tzarick/Battery-balancer/Software/Logic Flow Diagrams/I2C Coms/I2C Get State (I2C_Coms).pdf

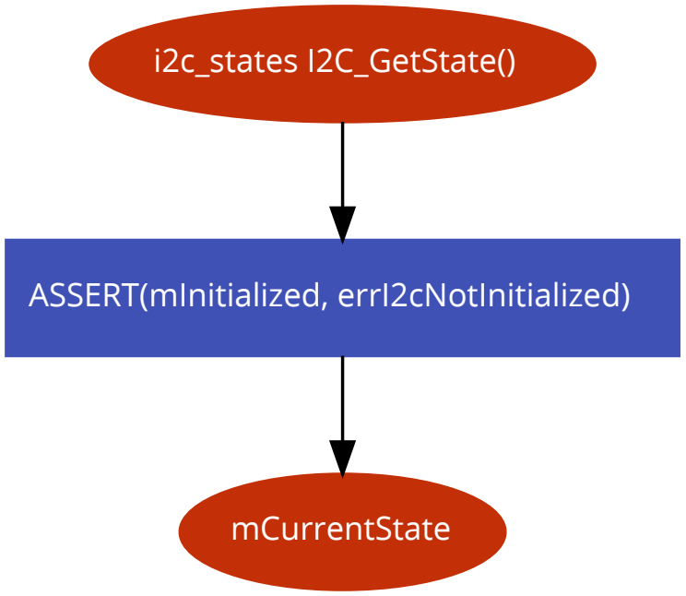
[picture p1: figure]
i2c_states I2C_GetState(); ASSERT(mInitialized, errI2cNotInitialized); mCurrentState
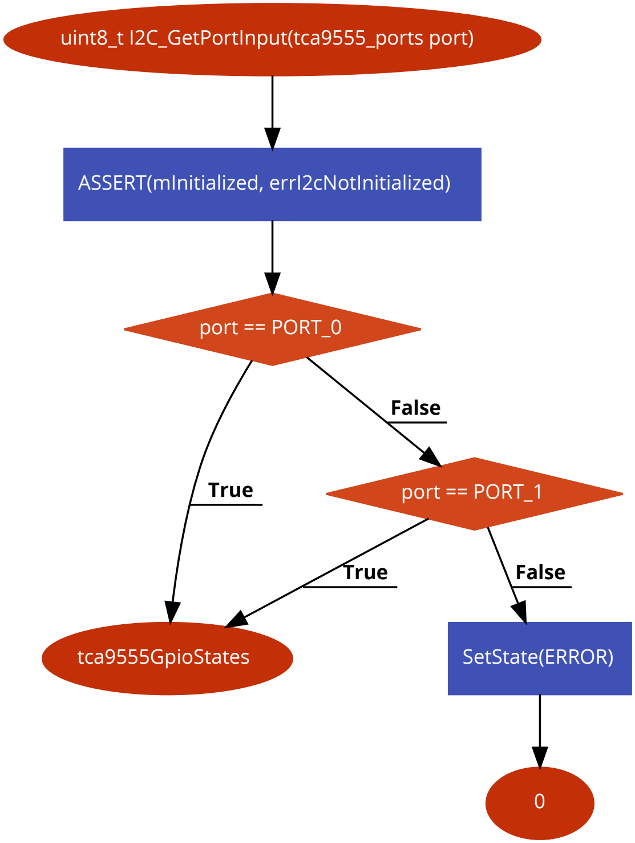
[picture p2: figure]
uint8_t I2C_GetPortInput(tca9555_ports port); ASSERT(mInitialized, errI2cNotInitialized); port == PORT_0; tca9555GpioStates; True; port == PORT_1; False; SetState(ERROR)
