tzarick/Battery-balancer/Software/Logic Flow Diagrams/I2C Coms/I2C Set Port Output  (I2C_Coms).pdf

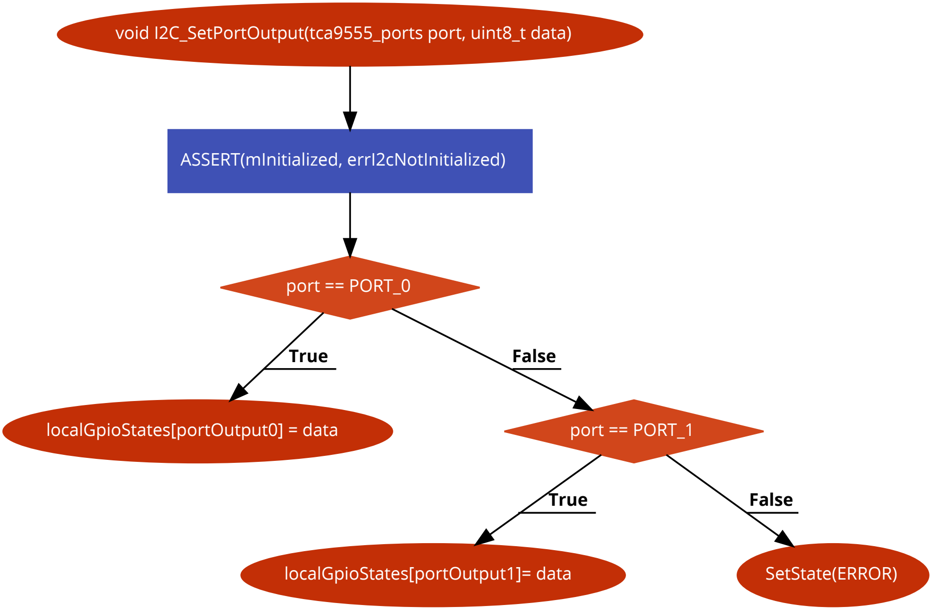
[picture p3: figure]
void I2C_SetPortOutput(tca9555_ports port, uint8_t data); ASSERT(mInitialized, errI2cNotInitialized); port == PORT_0; localGpioStates[portOutput0] = data; True; port == PORT_1; False; localGpioStates[portOutput1]= data; SetState(ERROR)
