tzarick/Battery-balancer/Software/Logic Flow Diagrams/I2C Coms/I2C_ReadRegister (I2C Coms).pdf

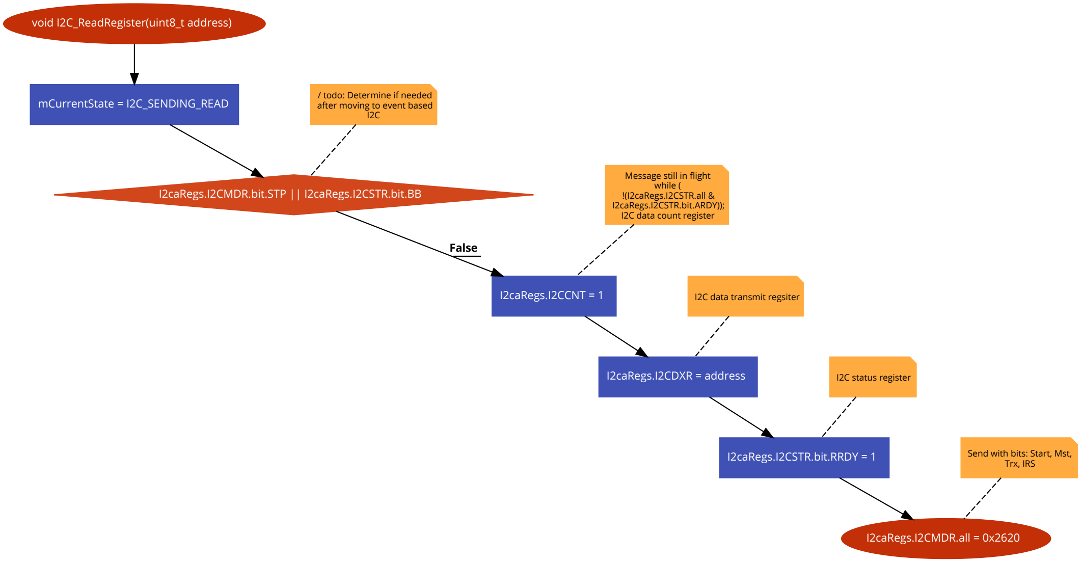
[picture p4: figure]
void I2C_ReadRegister(uint8_t address); mCurrentState = I2C_SENDING_READ; I2caRegs.I2CCNT = 1; False; I2caRegs.I2CDXR = address; I2caRegs.I2CSTR.bit.RRDY = 1; I2caRegs.I2CMDR.all = 0x2620; / todo: Determine if needed after moving to event based I2C; Message still in flight while ( !(I2caRegs.I2CSTR.all & I2caRegs.I2CSTR.bit.ARDY)); I2C data count register; I2C data transmit regsiter; I2C status register; Send with bits: Start, Mst, Trx, IRS

### I2caRegs.I2CMDR.bit.STP || I2caRegs.I2CSTR.bit.BB
