tzarick/Battery-balancer/Hardware/Front panel assembly BOM.xlsx

Qty | Description | Manufacturer | Mfg part | Vendor | Vendor part | Designator | Cost
5 | XH 3pos mating connector | JST | XHP-3 | Newark | 74M5178 |  | 0.043
5 | XH 4pos mating connector | JST | XHP-4 | Newark | 74M5179 |  | 0.059
2 | XH 2pos mating connector | JST | XHP-2 | Newark | 72M6922 |  | 0.039
1 | Micro-Clasp 10pos mating connector | Molex | 51353-1000 | Newark | 58J9303 |  | 0.5
10 | Micro-Clasp terminals | Molex | 56134-9100 | Newark | 59J0986 |  | 0.055
39 | XH terminals | JST | BXH-001T-P0.6 | Newark | 73M9274 |  | 0.069
1 | Green panel-mount pushbutton ind | CW Industries | GPB527C2L02BG1 |  |  |  | 4.34 | ?
1 | Red panel-mount pushbutton ind | CW Industries | GPB527C2L02BR1 |  |  |  | 3.53 | ?
2 | Toggle switches | NKK | M2011SS1W01/UC | Digi-Key | 360-3289-ND |  | 3.31
2 | Panel-mount green/yellow LED | Bivar | PM53-YGW12.0 | Newark | 73R3937 |  | 0.697
1 | LCD with serial backpack | SparkFun | na | SparkFun | LCD-09351 |  | 36.95 | buy it
2 | Panel-mount square momentary pushbutton | E-Switch | PS1057ABLK | Digi-Key | EG2041-ND |  | 1.35
1 | Emergency stop button | Automation Direct | GCX3131 |  |  |  | 9.25
1 | Audible alarm |  | DNP |  |  |  |  | dnp
1 | Front panel PCB - mount |  | PRINT |  |  |  |  | print
4 | M4 threaded insert |  | STOCK
4 | M4 screw |  | STOCK
 | LCD mounting hardware
1 | Front panel (plate with cutouts) |  | MFG HERE
1 | Magic CAN Node v2.3 |  | STOCK
1 | Smaller red panel-mount pushbutton ind | E-Switch | LP1OA1AR | Digi-Key | EG4643-ND |  | 2.95
 |  |  |  |  |  |  | 72.063
