tzarick/Battery-balancer/Hardware/RelayBoard/BoM.xlsx

Sensor Breakout Board V1.0
Qty | Description | Category | Manufacturer | Mfg part | Vendor | Vendor part | Unit cost | Designator
3 | TEXAS INSTRUMENTS DRV8860PW MOTOR DRIVER, STEPPER, 560MA, TSSOP-16 | Driver IC | TI | DRV8860PW | Newark | 11X3139 | $1.96 | U1-U3
24 | Miniature pc mount power relay. 12 Vdc, 400 Ohm coil. SPDT 12A contacts. | Relay | HASCO | KLT1C12DC12 | All Electronics | RLY-717 | $0.75 | K1-K24
24 | Wirewound Resistors THS50 R68 0.68 5% Ohms 50 W | Power Resistor | TE | THS50R68J | Mouser | 279-THS50R68J | $3.01 | R9-R16, R29-R36, R47-R54
1 | LED, Green, 1.25mm x 1.4mm, 570 nm, 2.1 V, 20 mA, 10 mcd | LED | Multicomp | MCL-S270GC | Newark | 14N9356 | $0.13 | LED26
25 | LED, Yellow, 1.25mm x 1.4mm, 590 nm, 2.1 V, 20 mA, 10 mcd | LED | Multicomp | MCL-S270YC | Newark | 14N9359 | $0.09 | LED1-LED25
26 | Surface Mount Chip Resistor, Thick Film, RC Series, 1 kohm, 100 mW, ± 5%, 50 V, 0603 [1608 Metric] (http://www.newark.com/yageo/rc0603jr-131kl/res-thick-film-1k-5-0-1w-0603/dp/68R0220) | Common passives | YAGEO (http://www.newark.com/yageo) | RC0603JR-131KL | Newark | 68R0220 | $0.002 | R1-R8, R19-R26, R37-R44, R55, R56
3 | Surface Mount Chip Resistor, Thick Film, AEC-Q200 CRCW Series, 10 kohm, 100 mW, ± 5%, 75 V (http://www.newark.com/vishay-dale/crcw060310k0jnea/res-thick-film-10k-5-0-1w-0603/dp/52K8066) | Common passives | VISHAY (http://www.newark.com/vishay) | CRCW060310K0JNEA | Newark | 52K8066 | $0.03 | R18, R28, R46
3 | Surface Mount Chip Resistor, Thick Film, AEC-Q200 CRCW Series, 14 kohm, 100 mW, ± 1%, 75 V | Common passives | VISHAY (http://www.newark.com/vishay) | CRCW060314K0FKEA | Newark | 52K8133 | $0.004 | R17, R27, R45
3 | SMD Multilayer Ceramic Capacitor, C Series, 0.1 µF, ± 5%, X7R, 25 V, 0603 [1608 Metric] | Common passives | KEMET | C0603C104J3RACTU | Newark | 01J3308 | $0.04 | C2, C5, C8
3 | SMD Multilayer Ceramic Capacitor, 10 µF, ± 10%, X5R, 6.3 V, 0805 [2012 Metric] | Common passives | AVX | 08056D106KAT2A | Newark | 84K8398 | $0.02 | C1, C4, C7
1 | Board-To-Board Connector, MTA-100 Series, Through Hole, Header, 10, 2.54 mm, Tin Plated Contacts | Connectors | TE CONNECTIVITY / AMP (http://www.newark.com/te-connectivity-amp) | 4-644456-0 | Newark | 15M6349 | $0.63 | JP1-JP5
1 | Wire-To-Board Connector, Micro-Fit 3.0 43045 Series, Through Hole, Header, 12, 3 mm | Connectors | MOLEX (http://www.newark.com/molex) | 43045-1200 | Newark | 56H9564 | $2.80 | X3
 | Subtotal |  |  |  |  |  | $102.37
