tzarick/Battery-balancer/CAD/Balancer/Balancer enclosure.SLDASM

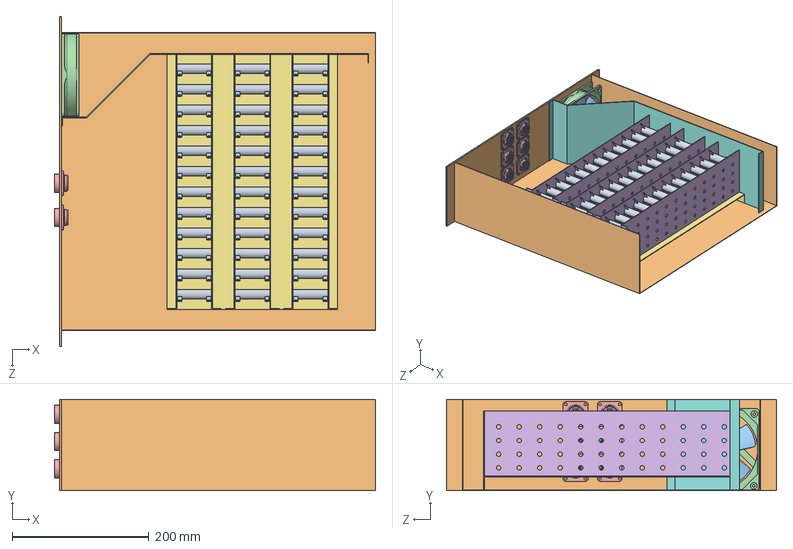
[picture p7: CAD file, 2016-03-14]
CAD/Balancer/Balancer enclosure.SLDASM
469.7 x 133.4 x 482.6 mm
Ohmite L25J1R0E x 144
Vero 503-232949F 3U enclosure
Fan
Fan Housing
205840-3 CPC Series 2 28pos x 6
Resistor side wall x 6
Resistor array bottom wall^Balancer enclosure
Intake manifold wall^Balancer enclosure
