tzarick/Battery-balancer/CAD/Front panel/Front panel printed.SLDASM

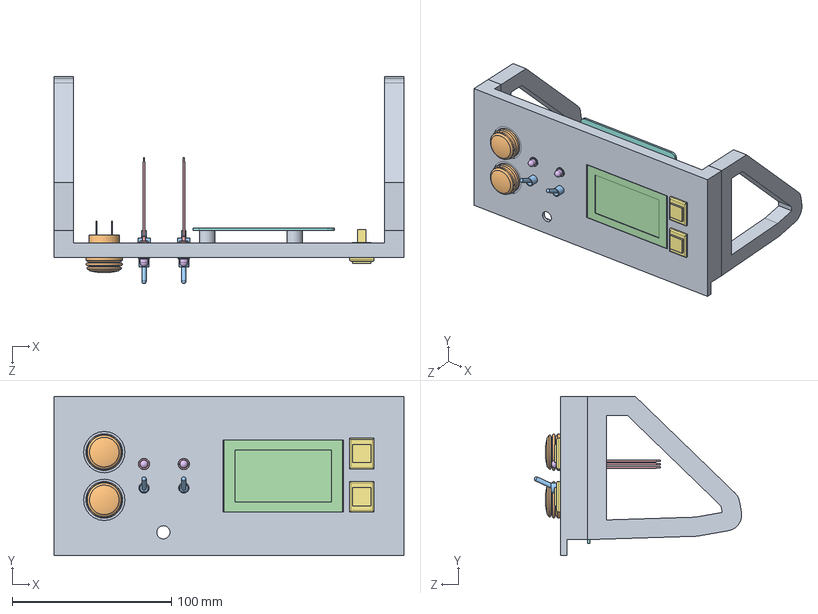
[picture p9: CAD file, 2016-03-14]
CAD/Front panel/Front panel printed.SLDASM
220.0 x 100.0 x 130.4 mm
Front panel print
GPB527C2L02BG1 pushbutton switch x 2
M2011SS1W01 toggle switch x 2
LCD
PM5-3_A1 x 2
LED_5mm x 2
TP11J81ZQE22 pushbutton x 2
Front panel PCB
Foot thing x 2
