tzarick/Battery-balancer/CAD/Front panel/Front panel subcomponents/Front panel PCB.SLDASM

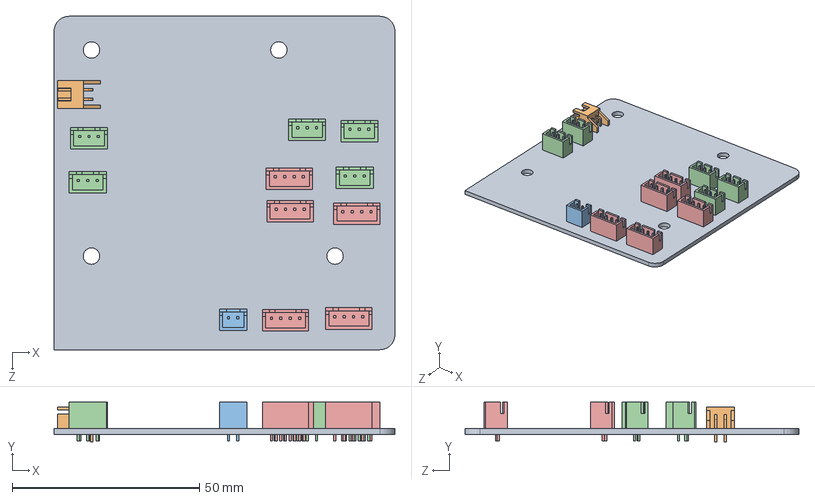
[picture p10: CAD file, 2016-03-14]
CAD/Front panel/Front panel subcomponents/Front panel PCB.SLDASM
91.0 x 10.7 x 89.0 mm
Front panel PCB
B2B-XH-A 2pos RA
B2B-XH-A 2pos vert
B3B-XH-A 3pos vert x 5
B4B-XH-A 4pos vert x 5
