tzarick/Battery-balancer/CAD/Front panel/Front panel subcomponents/Front panel.SLDPRT

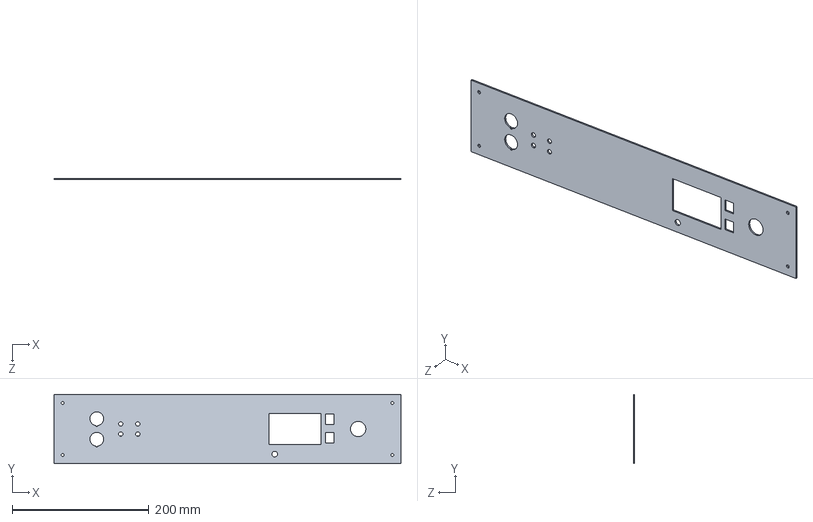
[picture p14: CAD file, 2016-03-14]
CAD/Front panel/Front panel subcomponents/Front panel.SLDPRT
508.0 x 101.6 x 2.10 mm
