tzarick/Battery-balancer/CAD/Front panel/Printing subcomponents/Foot thing.SLDPRT

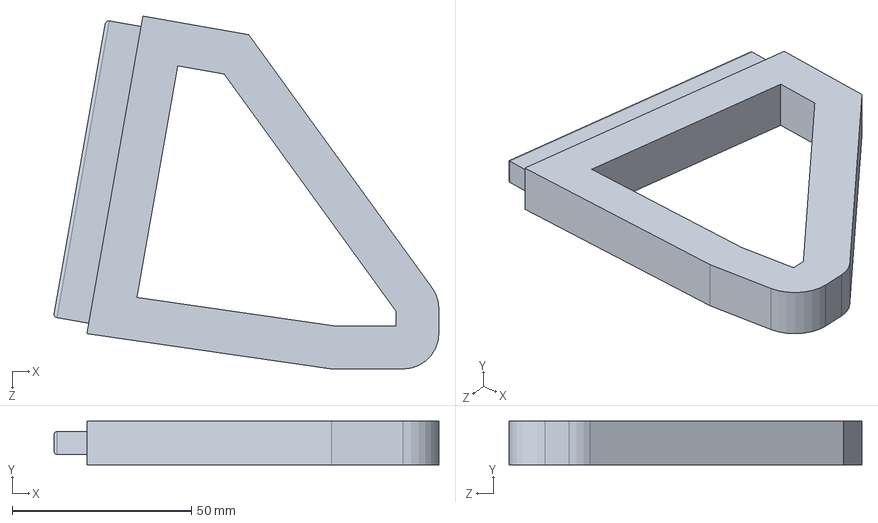
[picture p15: CAD file, 2016-03-14]
CAD/Front panel/Printing subcomponents/Foot thing.SLDPRT
107.4 x 12.2 x 98.5 mm
