tzarick/Battery-balancer/CAD/Balancer/Electrical components/Vero 503-232949F 3U enclosure.SLDPRT

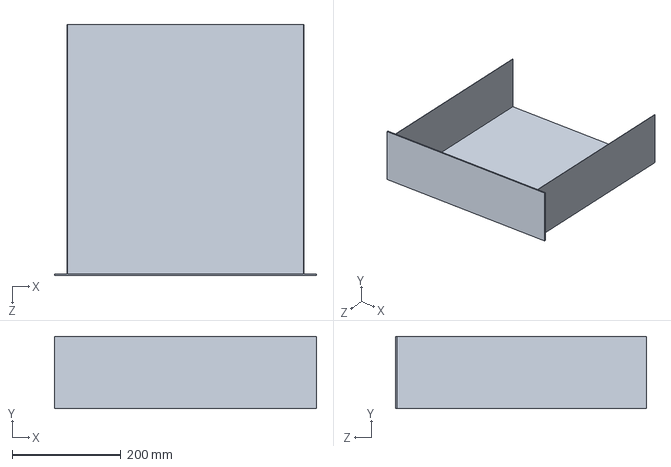
[picture p21: CAD file, 2016-03-14]
CAD/Balancer/Electrical components/Vero 503-232949F 3U enclosure.SLDPRT
482.6 x 133.4 x 462.0 mm
