tzarick/Battery-balancer/CAD/Front panel/Front panel subcomponents/Front panel print.SLDPRT

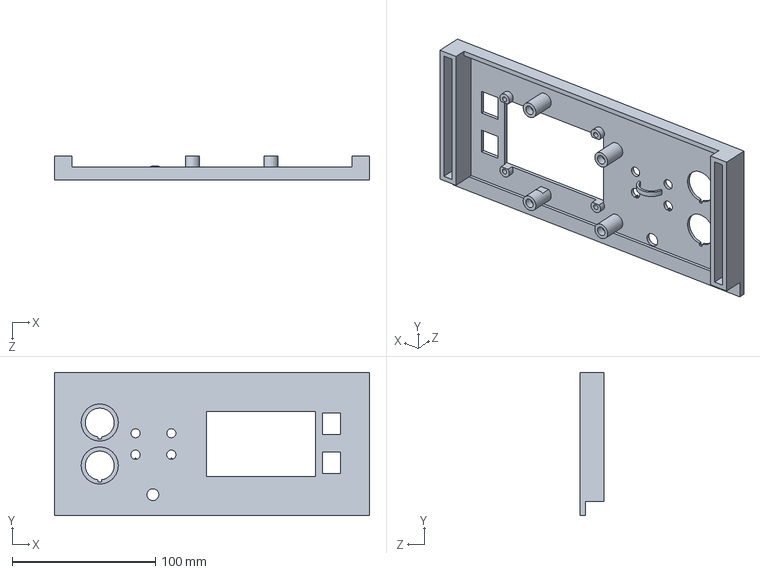
[picture p22: CAD file, 2016-03-14]
CAD/Front panel/Front panel subcomponents/Front panel print.SLDPRT
220.0 x 100.0 x 17.1 mm
