tzarick/Battery-balancer/CAD/Front panel/Front panel subcomponents/LCD.SLDPRT

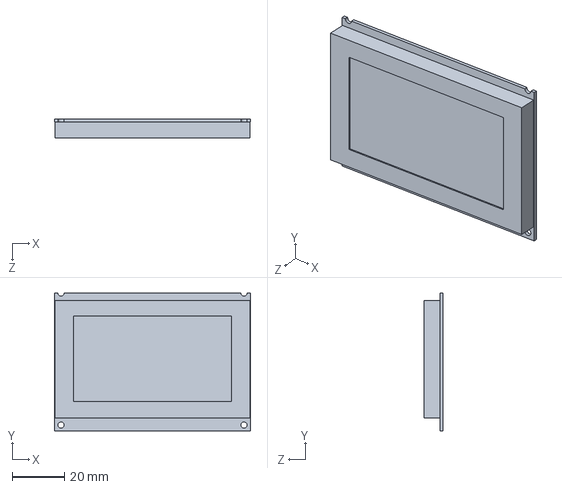
[picture p23: CAD file, 2016-03-14]
CAD/Front panel/Front panel subcomponents/LCD.SLDPRT
75.0 x 52.8 x 7.10 mm
