tzarick/Battery-balancer/CAD/Front panel/Front panel subcomponents/M2011SS1W01 toggle switch.SLDPRT

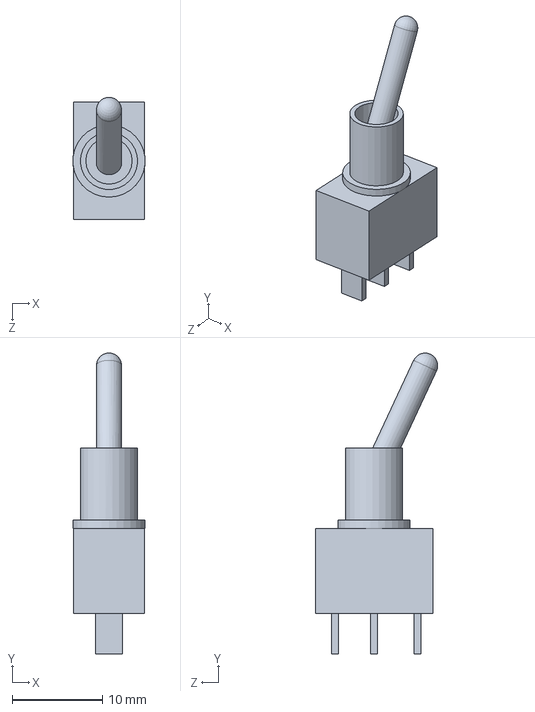
[picture p24: CAD file, 2016-03-14]
CAD/Front panel/Front panel subcomponents/M2011SS1W01 toggle switch.SLDPRT
7.96 x 33.3 x 13.5 mm
