tzarick/Battery-balancer/Software/Logic Flow Diagrams/CAN/SetupMailBoxes (CAN).pdf

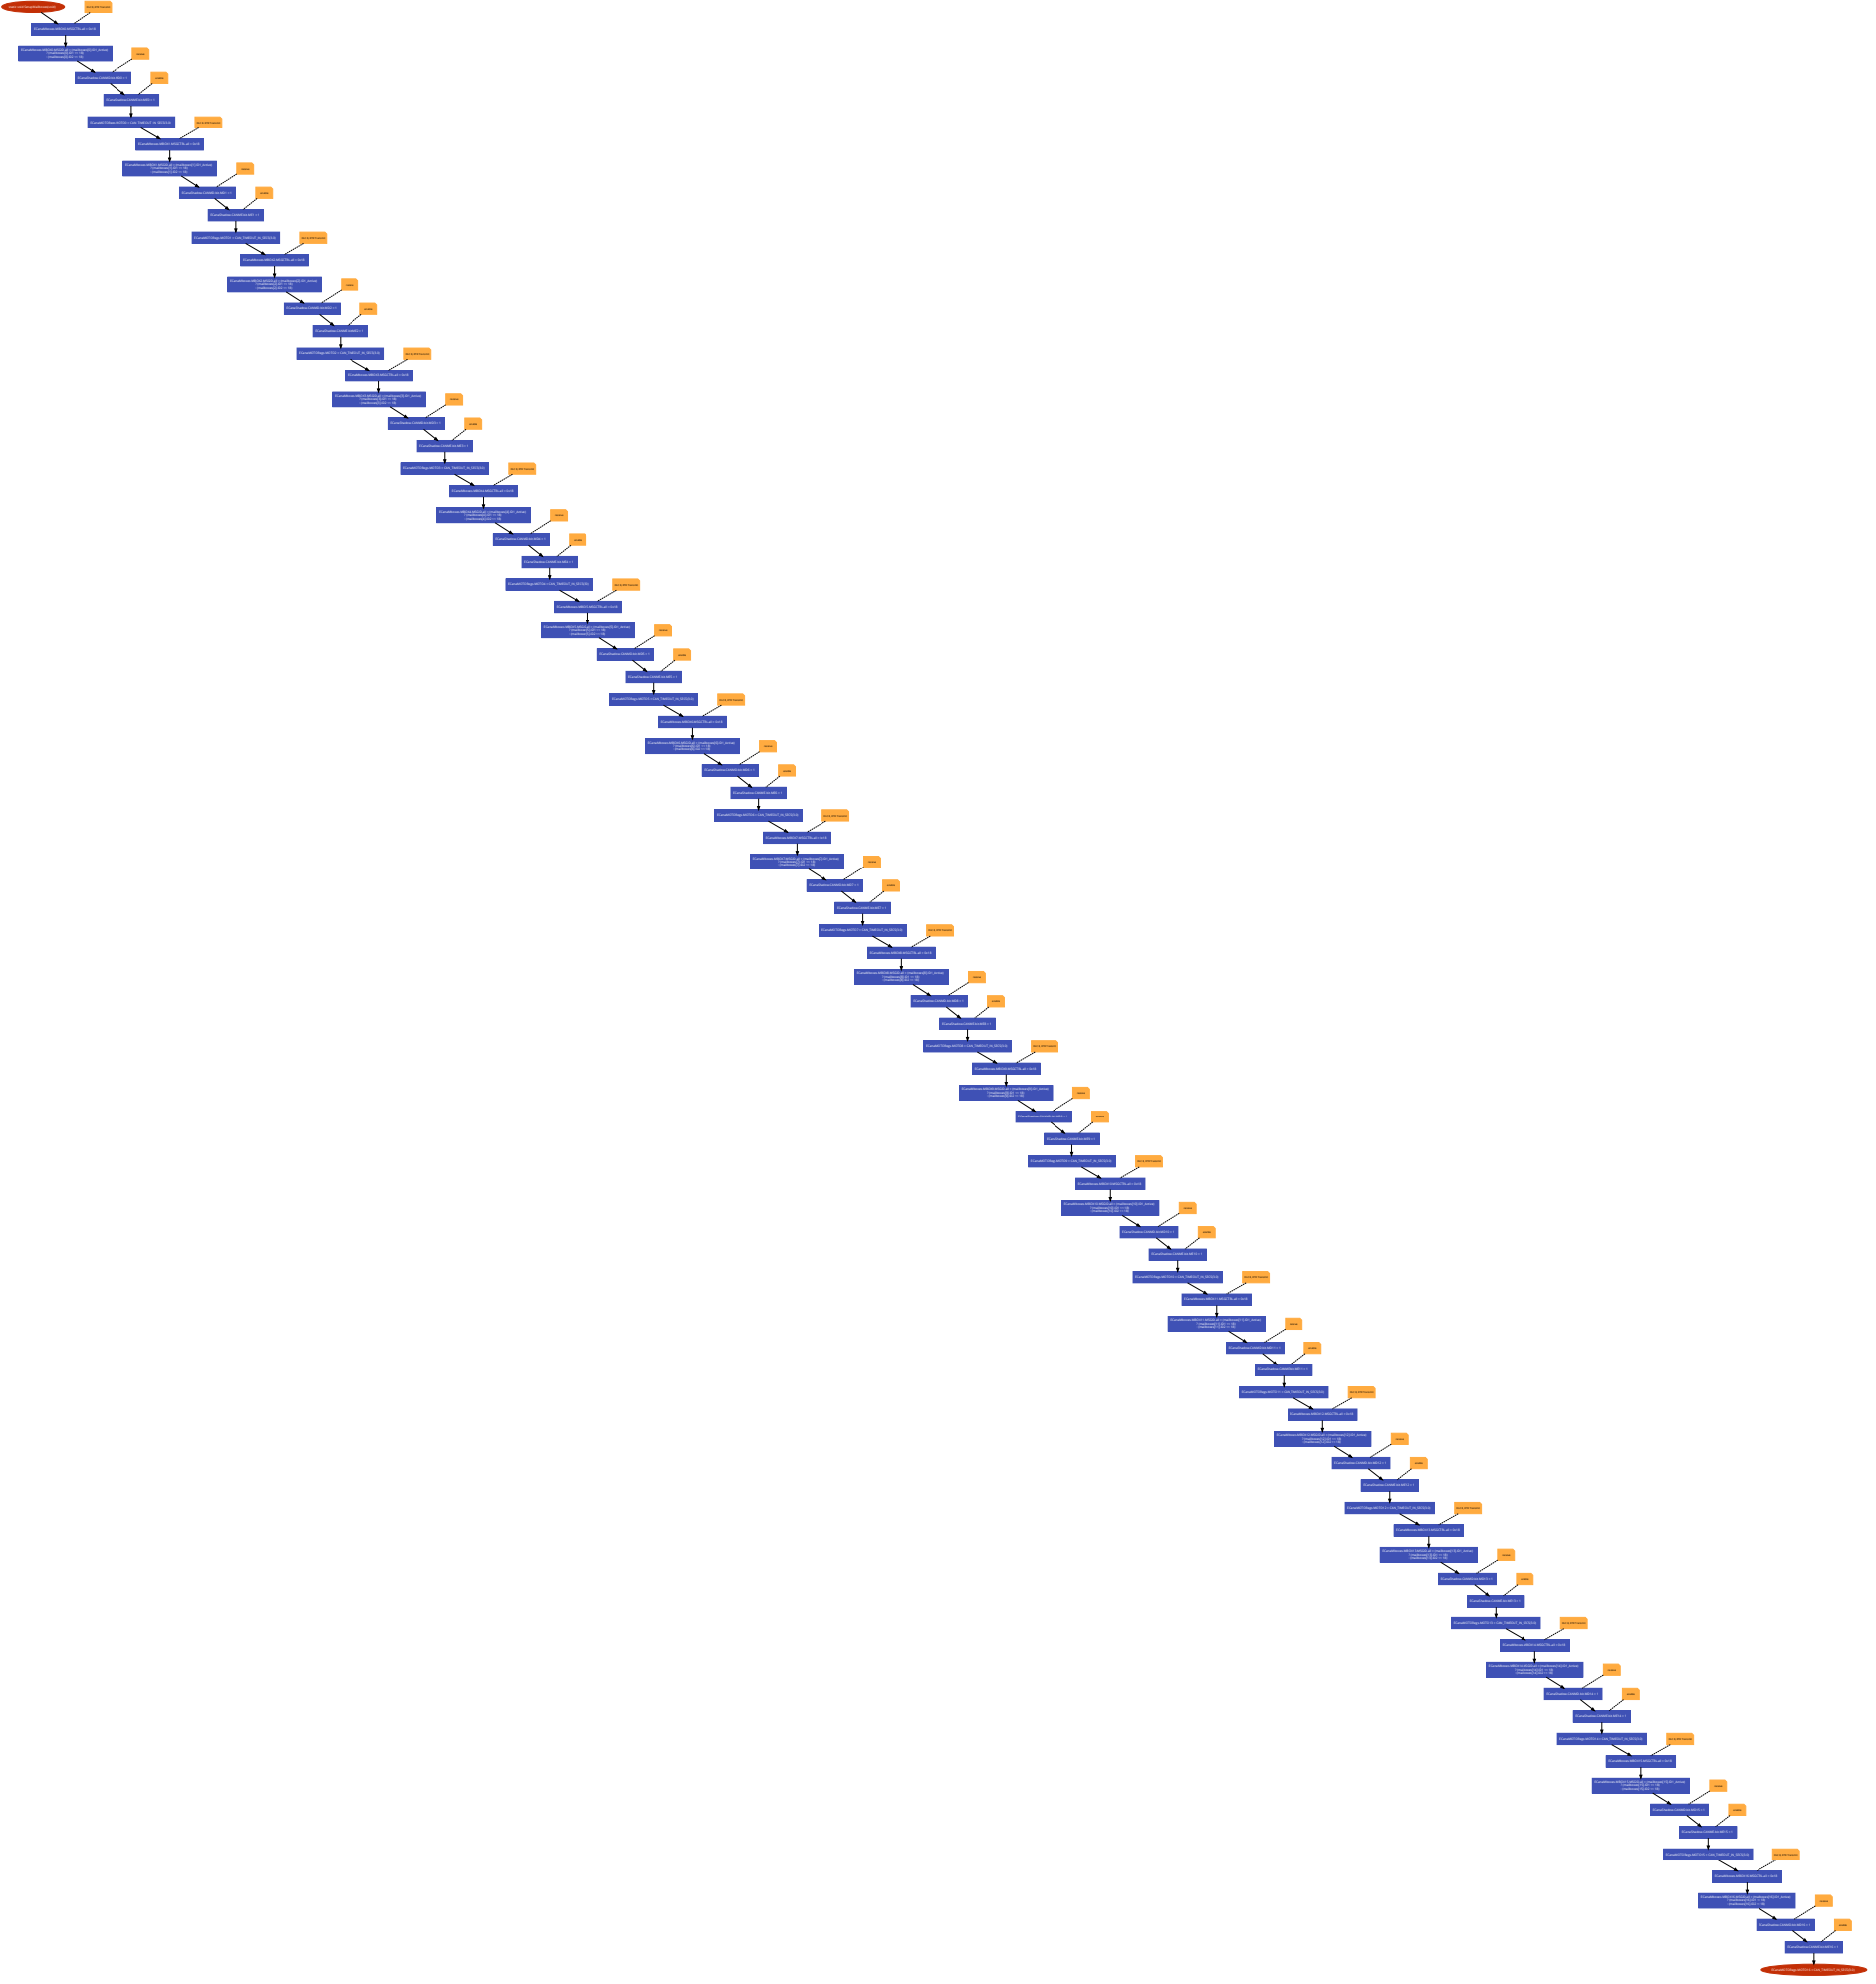
[picture p25: page 1]
? (mailboxes[0].ID1 << 18) : (mailboxes[0].ID2 << 18); ECanaMOTORegs.MOTO0 = CAN_TIMEOUT_IN_SECS(3.0); ? (mailboxes[1].ID1 << 18) : (mailboxes[1].ID2 << 18); ECanaMOTORegs.MOTO1 = CAN_TIMEOUT_IN_SECS(3.0); ? (mailboxes[2].ID1 << 18) : (mailboxes[2].ID2 << 18); ECanaMOTORegs.MOTO2 = CAN_TIMEOUT_IN_SECS(3.0); ? (mailboxes[3].ID1 << 18) : (mailboxes[3].ID2 << 18); ECanaMOTORegs.MOTO3 = CAN_TIMEOUT_IN_SECS(3.0); ? (mailboxes[4].ID1 << 18) : (mailboxes[4].ID2 << 18)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

static void SetupMailboxes(void)

DLC 8, RTR Transmit

ECanaMboxes.MBOX0.MSGCTRL.all = 0x18

ECanaMboxes.MBOX0.MSGID.all = (mailboxes[0].ID1_Active)

ECanaShadow.CANMD.bit.MD0 = 1

ECanaShadow.CANME.bit.ME0 = 1

ECanaMboxes.MBOX1.MSGCTRL.all = 0x18

ECanaMboxes.MBOX1.MSGID.all = (mailboxes[1].ID1_Active)

ECanaShadow.CANMD.bit.MD1 = 1

ECanaShadow.CANME.bit.ME1 = 1

ECanaMboxes.MBOX2.MSGCTRL.all = 0x18

ECanaMboxes.MBOX2.MSGID.all = (mailboxes[2].ID1_Active)

ECanaShadow.CANMD.bit.MD2 = 1

ECanaShadow.CANME.bit.ME2 = 1

ECanaMboxes.MBOX3.MSGCTRL.all = 0x18

ECanaMboxes.MBOX3.MSGID.all = (mailboxes[3].ID1_Active)

ECanaShadow.CANMD.bit.MD3 = 1

ECanaShadow.CANME.bit.ME3 = 1

ECanaMboxes.MBOX4.MSGCTRL.all = 0x18

ECanaMboxes.MBOX4.MSGID.all = (mailboxes[4].ID1_Active)

ECanaShadow.CANMD.bit.MD4 = 1

ECanaShadow.CANME.bit.ME4 = 1

ECanaMboxes.MBOX5.MSGCTRL.all = 0x18

ECanaMboxes.MBOX5.MSGID.all = (mailboxes[5].ID1_Active)

ECanaShadow.CANMD.bit.MD5 = 1

ECanaShadow.CANME.bit.ME5 = 1

ECanaMboxes.MBOX6.MSGCTRL.all = 0x18

ECanaMboxes.MBOX6.MSGID.all = (mailboxes[6].ID1_Active)

ECanaShadow.CANMD.bit.MD6 = 1

ECanaShadow.CANME.bit.ME6 = 1

ECanaMboxes.MBOX7.MSGCTRL.all = 0x18

ECanaMboxes.MBOX7.MSGID.all = (mailboxes[7].ID1_Active)

ECanaShadow.CANMD.bit.MD7 = 1

ECanaShadow.CANME.bit.ME7 = 1

ECanaMboxes.MBOX8.MSGCTRL.all = 0x18

ECanaMboxes.MBOX8.MSGID.all = (mailboxes[8].ID1_Active)

ECanaShadow.CANMD.bit.MD8 = 1

ECanaShadow.CANME.bit.ME8 = 1

ECanaMboxes.MBOX9.MSGCTRL.all = 0x18

ECanaMboxes.MBOX9.MSGID.all = (mailboxes[9].ID1_Active)

ECanaShadow.CANMD.bit.MD9 = 1

ECanaShadow.CANME.bit.ME9 = 1

ECanaMboxes.MBOX10.MSGCTRL.all = 0x18

ECanaMboxes.MBOX10.MSGID.all = (mailboxes[10].ID1_Active)

ECanaShadow.CANMD.bit.MD10 = 1

ECanaShadow.CANME.bit.ME10 = 1

ECanaMboxes.MBOX11.MSGCTRL.all = 0x18

ECanaMboxes.MBOX11.MSGID.all = (mailboxes[11].ID1_Active)

ECanaShadow.CANMD.bit.MD11 = 1

ECanaShadow.CANME.bit.ME11 = 1

ECanaMboxes.MBOX12.MSGCTRL.all = 0x18

ECanaMboxes.MBOX12.MSGID.all = (mailboxes[12].ID1_Active)

ECanaShadow.CANMD.bit.MD12 = 1

ECanaShadow.CANME.bit.ME12 = 1

ECanaMboxes.MBOX13.MSGCTRL.all = 0x18

ECanaMboxes.MBOX13.MSGID.all = (mailboxes[13].ID1_Active)

ECanaShadow.CANMD.bit.MD13 = 1

ECanaShadow.CANME.bit.ME13 = 1

ECanaMboxes.MBOX14.MSGCTRL.all = 0x18

ECanaMboxes.MBOX14.MSGID.all = (mailboxes[14].ID1_Active)

ECanaShadow.CANMD.bit.MD14 = 1

ECanaShadow.CANME.bit.ME14 = 1

ECanaMboxes.MBOX15.MSGCTRL.all = 0x18

ECanaMboxes.MBOX15.MSGID.all = (mailboxes[15].ID1_Active)

ECanaShadow.CANMD.bit.MD15 = 1

ECanaShadow.CANME.bit.ME15 = 1

ECanaMboxes.MBOX16.MSGCTRL.all = 0x18

ECanaMboxes.MBOX16.MSGID.all = (mailboxes[16].ID1_Active)

ECanaShadow.CANMD.bit.MD16 = 1

ECanaShadow.CANME.bit.ME16 = 1
