tzarick/Battery-balancer/Software/Logic Flow Diagrams/BatteryController.pdf

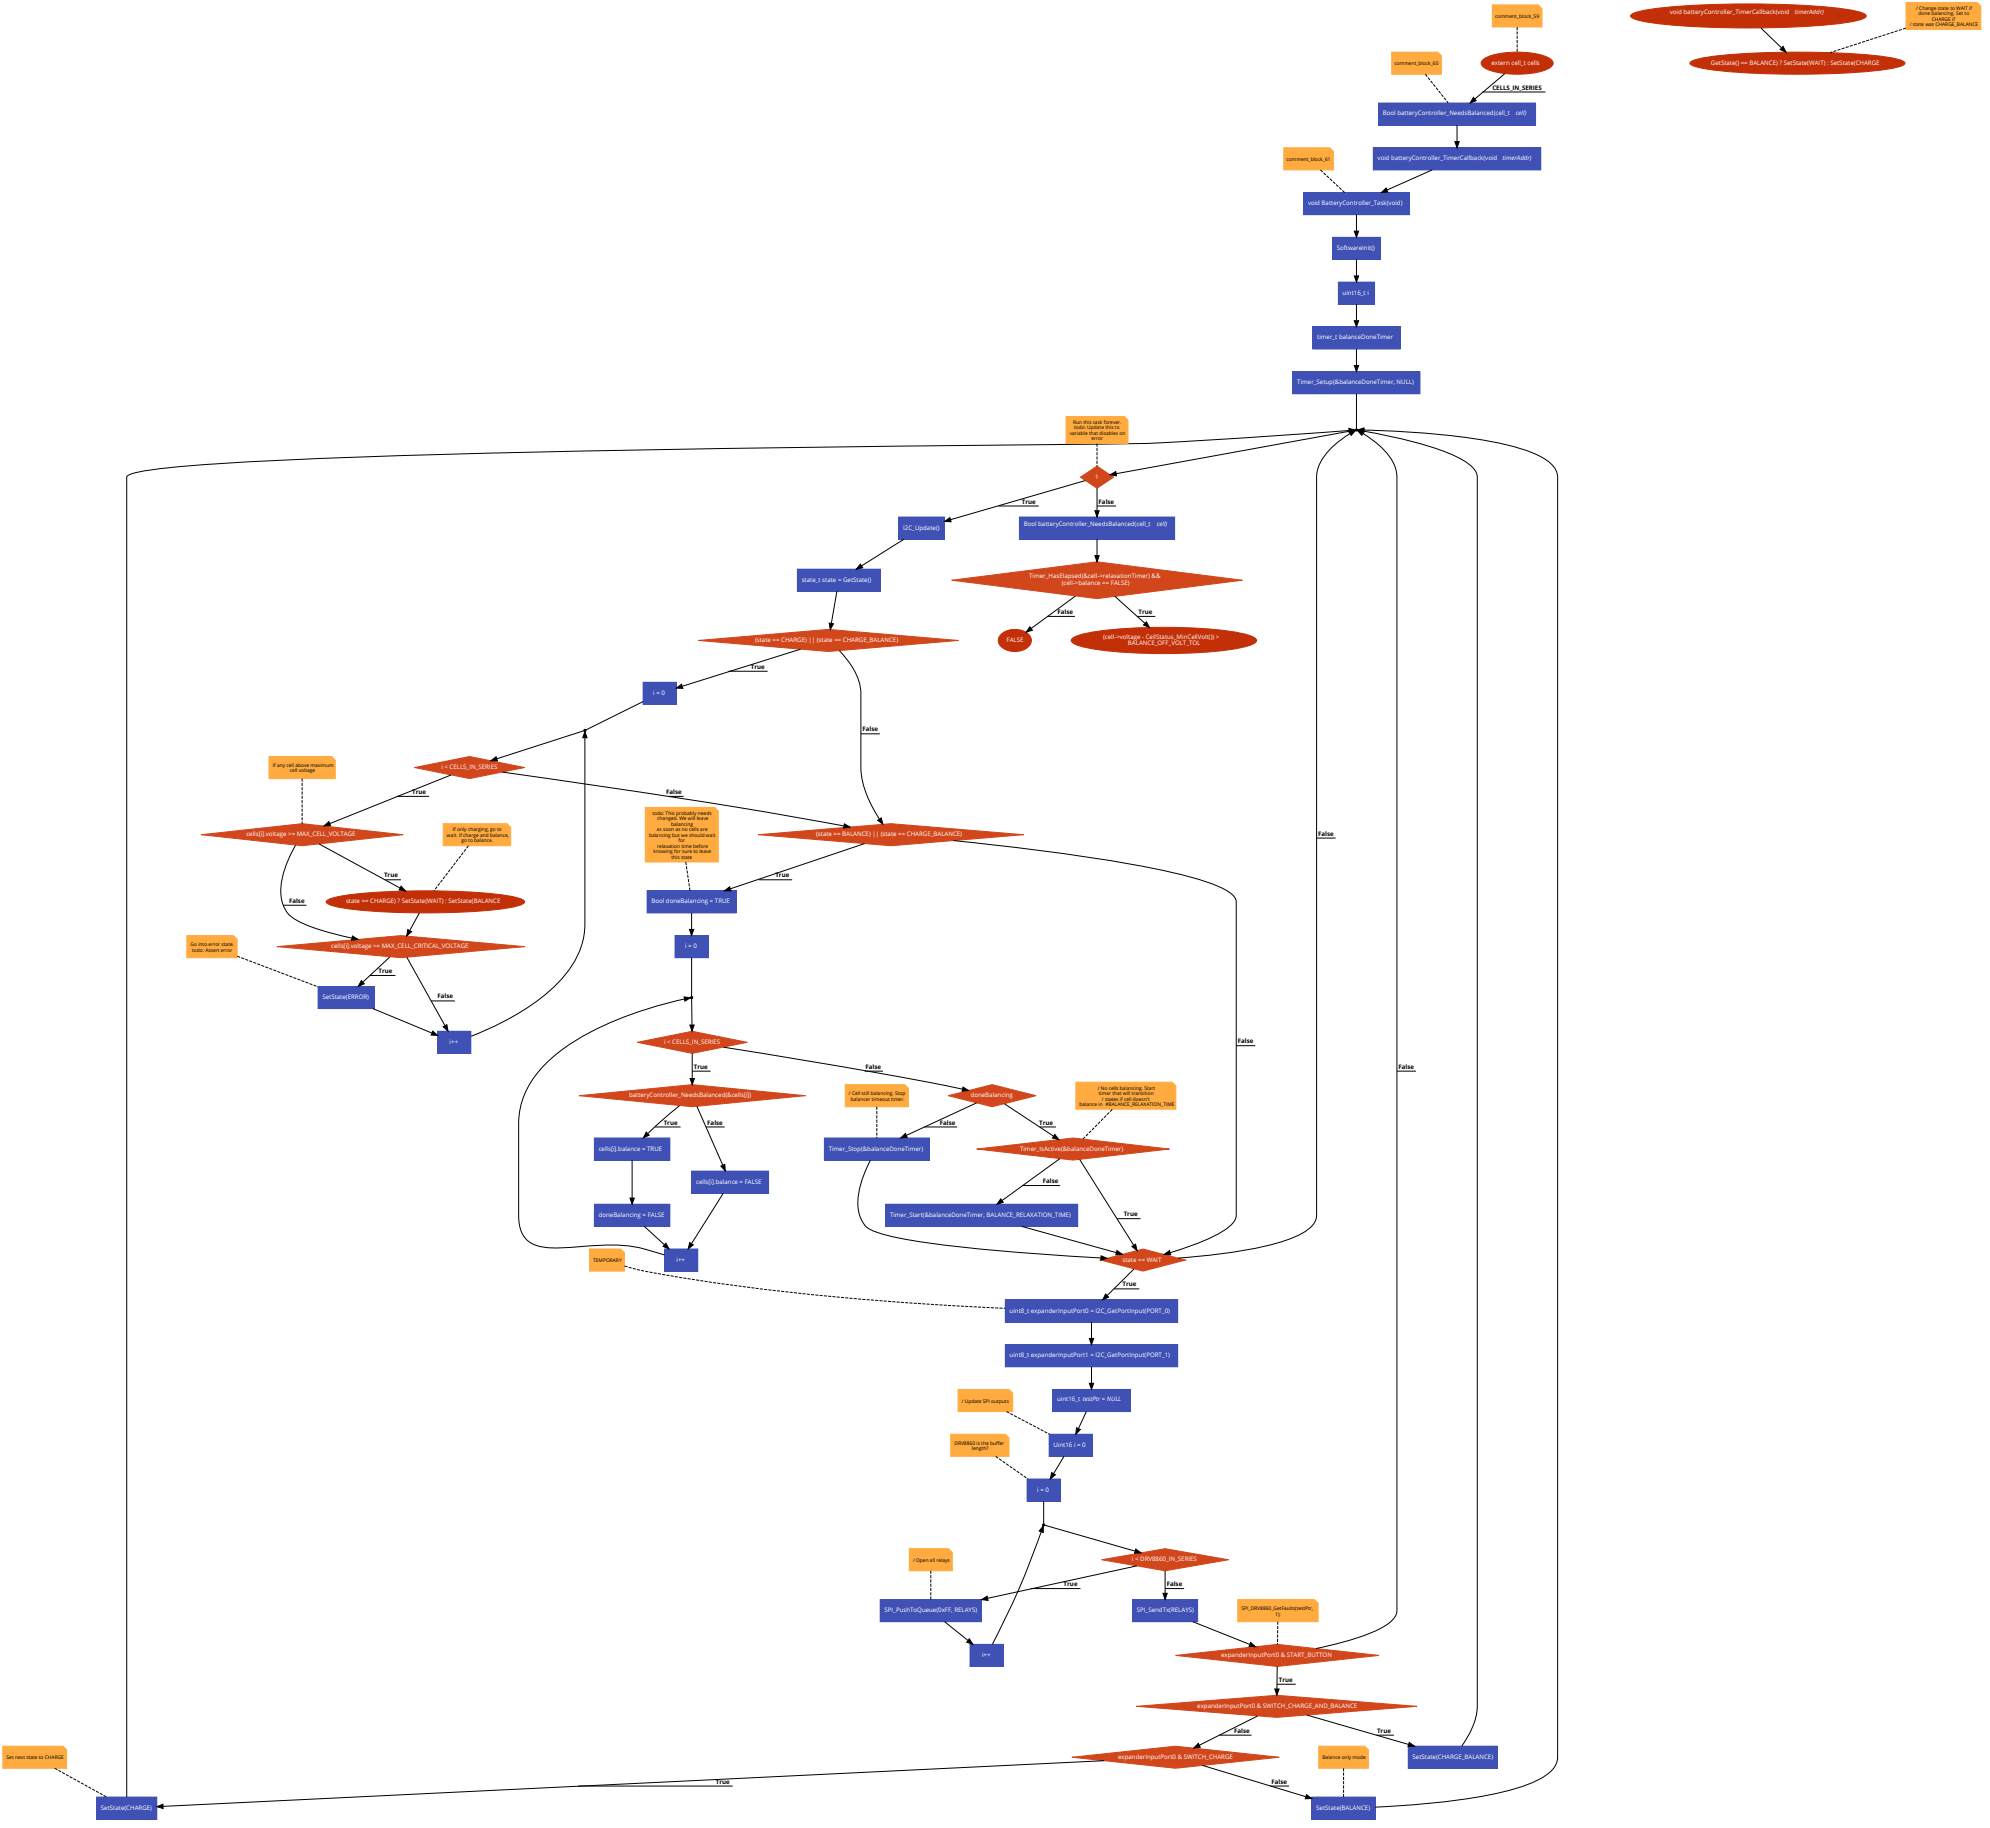
[picture p26: page 1]
extern cell_t cells; Bool batteryController_NeedsBalanced(cell_t cell); CELLS_IN_SERIES; void BatteryController_Task(void); SoftwareInit(); uint16_t i; timer_t balanceDoneTimer; Timer_Setup(&balanceDoneTimer, NULL); I2C_Update(); True; False; state_t state = GetState(); i < CELLS_IN_SERIES; cells[i].voltage >= MAX_CELL_VOLTAGE; cells[i].voltage >= MAX_CELL_CRITICAL_VOLTAGE; SetState(ERROR); state == WAIT; batteryController_NeedsBalanced(&cells[i]); doneBalancing; doneBalancing = FALSE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

void batteryController_TimerCallback(void timerAddr)

/ Change state to WAIT if
done balancing. Set to
CHARGE if

GetState() == BALANCE) ? SetState(WAIT) : SetState(CHARGE

Run this task forever.
todo: Update this to
variable that disables on

(cell->balance == FALSE)

(state == CHARGE) || (state == CHARGE_BALANCE)

If any cell above maximum
cell voltage

todo: This probably needs
changed. We will leave
balancing
as soon as no cells are
balancing but we should wait
relaxation time before
knowing for sure to leave
this state

If only charging, go to
wait. If charge and balance,
go to balance.

(state == BALANCE) || (state == CHARGE_BALANCE)

state == CHARGE) ? SetState(WAIT) : SetState(BALANCE

Bool doneBalancing = TRUE

Go into error state.
todo: Assert error

/ Cell still balancing. Stop
balancer timeout timer.

/ No cells balancing. Start
timer that will transition
/ states if cell doesn't

cells[i].balance = TRUE

cells[i].balance = FALSE

/ Update SPI outputs

DRV8860 is the buffer
length?

/ Open all relays
