tzarick/Battery-balancer/Software/Logic Flow Diagrams/BatteryControllerFunc.pdf

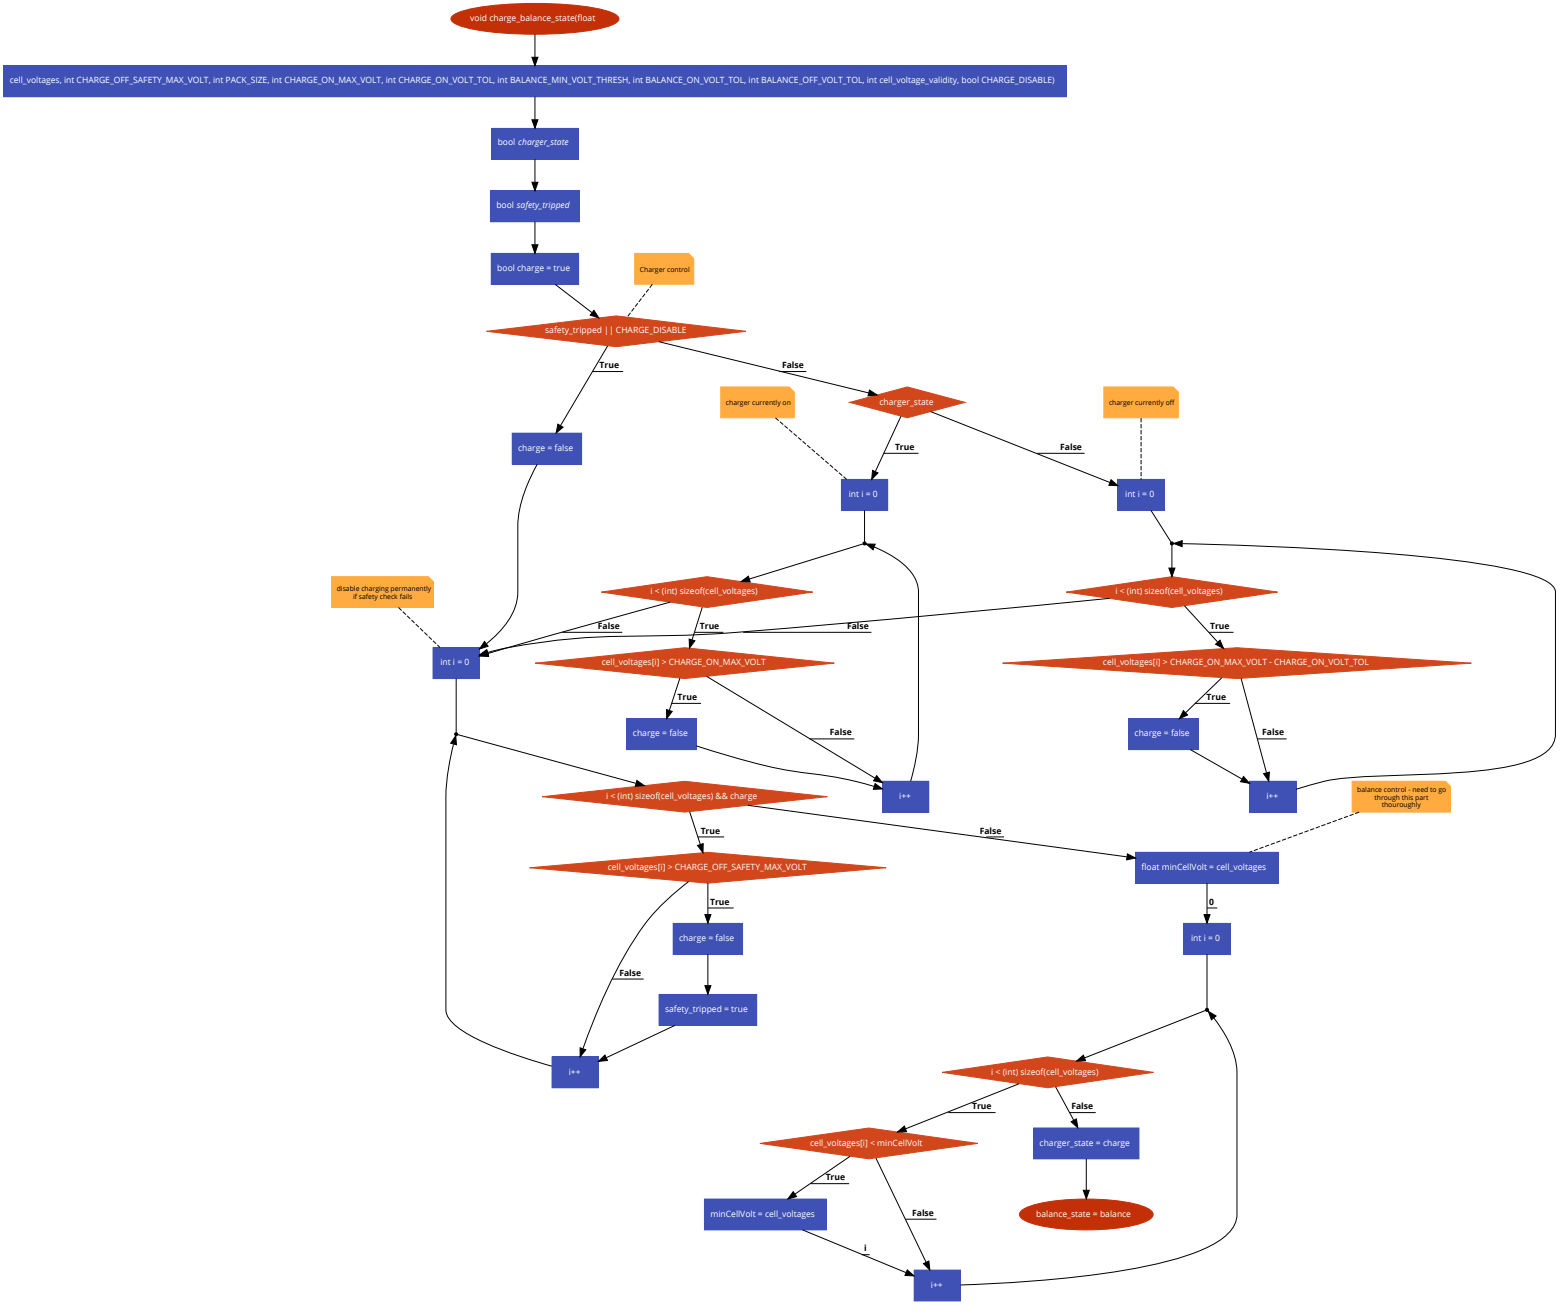
[picture p27: page 1]
void charge_balance_state(float; bool charger_state; bool safety_tripped; safety_tripped || CHARGE_DISABLE; charge = false; True; charger_state; False; int i = 0; i < (int) sizeof(cell_voltages); cell_voltages[i] > CHARGE_ON_MAX_VOLT - CHARGE_ON_VOLT_TOL; cell_voltages[i] > CHARGE_ON_MAX_VOLT; cell_voltages[i] > CHARGE_OFF_SAFETY_MAX_VOLT; float minCellVolt = cell_voltages; safety_tripped = true; cell_voltages[i] < minCellVolt; charger_state = charge; minCellVolt = cell_voltages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

cell_voltages, int CHARGE_OFF_SAFETY_MAX_VOLT, int PACK_SIZE, int CHARGE_ON_MAX_VOLT, int CHARGE_ON_VOLT_TOL, int BALANCE_MIN_VOLT_THRESH, int BALANCE_ON_VOLT_TOL, int BALANCE_OFF_VOLT_TOL, int cell_voltage_validity, bool CHARGE_DISABLE)

bool charge = true

disable charging permanently
if safety check fails

balance control - need to go
through this part
thouroughly

i < (int) sizeof(cell_voltages) && charge
