tzarick/Battery-balancer/Software/Logic Flow Diagrams/Cell Balancing Holdoff.pdf

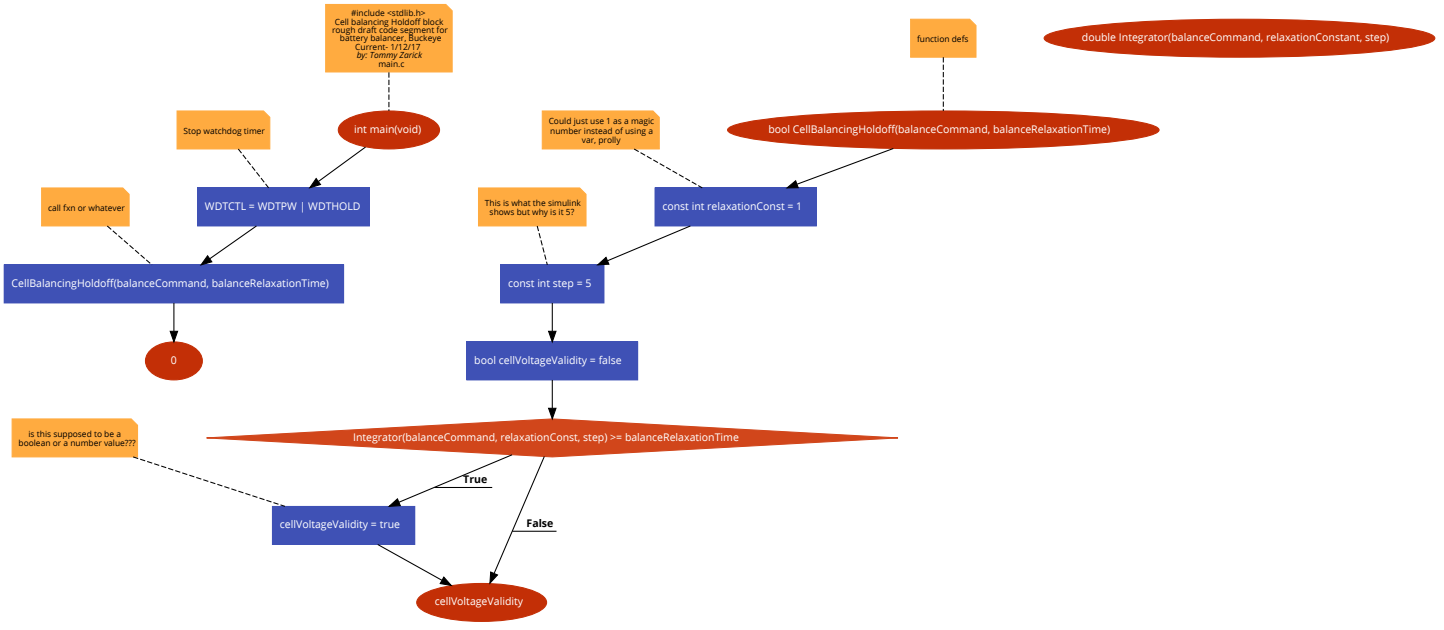
[picture p28: page 1]
cellVoltageValidity = true; True; cellVoltageValidity; False; function defs

#include <stdlib.h>
Cell balancing Holdoff block
rough draft code segment for
battery balancer, Buckeye
Current- 1/12/17
by: Tommy Zarick
main.c

double Integrator(balanceCommand, relaxationConstant, step)

Stop watchdog timer

int main(void)

Could just use 1 as a magic
number instead of using a
var, prolly

bool CellBalancingHoldoff(balanceCommand, balanceRelaxationTime)

call fxn or whatever

WDTCTL = WDTPW | WDTHOLD

This is what the simulink
shows but why is it 5?

const int relaxationConst = 1

CellBalancingHoldoff(balanceCommand, balanceRelaxationTime)

const int step = 5

bool cellVoltageValidity = false

is this supposed to be a
boolean or a number value???

Integrator(balanceCommand, relaxationConst, step) >= balanceRelaxationTime
