tzarick/Battery-balancer/Software/Logic Flow Diagrams/CellStatus.pdf

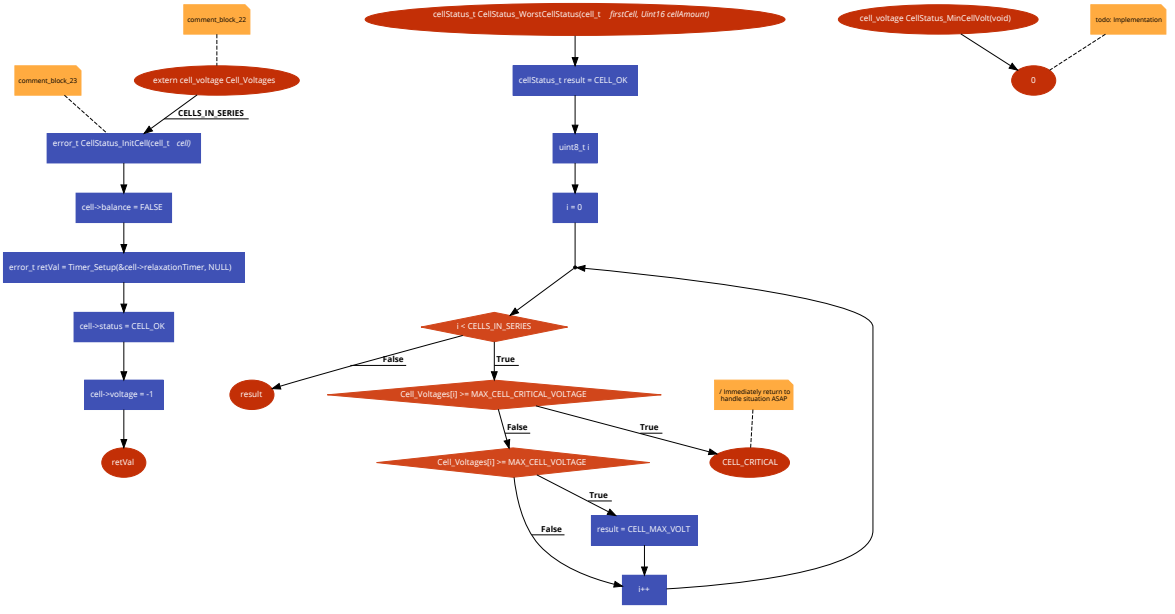
[picture p29: page 1]
extern cell_voltage Cell_Voltages; error_t CellStatus_InitCell(cell_t cell); CELLS_IN_SERIES; cell->status = CELL_OK; cell->voltage = -1; retVal; cellStatus_t CellStatus_WorstCellStatus(cell_t firstCell, Uint16 cellAmount); cellStatus_t result = CELL_OK; uint8_t i; i < CELLS_IN_SERIES; Cell_Voltages[i] >= MAX_CELL_CRITICAL_VOLTAGE; True; result; False; CELL_CRITICAL; Cell_Voltages[i] >= MAX_CELL_VOLTAGE; result = CELL_MAX_VOLT; cell_voltage CellStatus_MinCellVolt(void); comment_block_22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

cell->balance = FALSE

error_t retVal = Timer_Setup(&cell->relaxationTimer, NULL)

/ Immediately return to
handle situation ASAP
