tzarick/Battery-balancer/Software/Logic Flow Diagrams/Front Panel.pdf

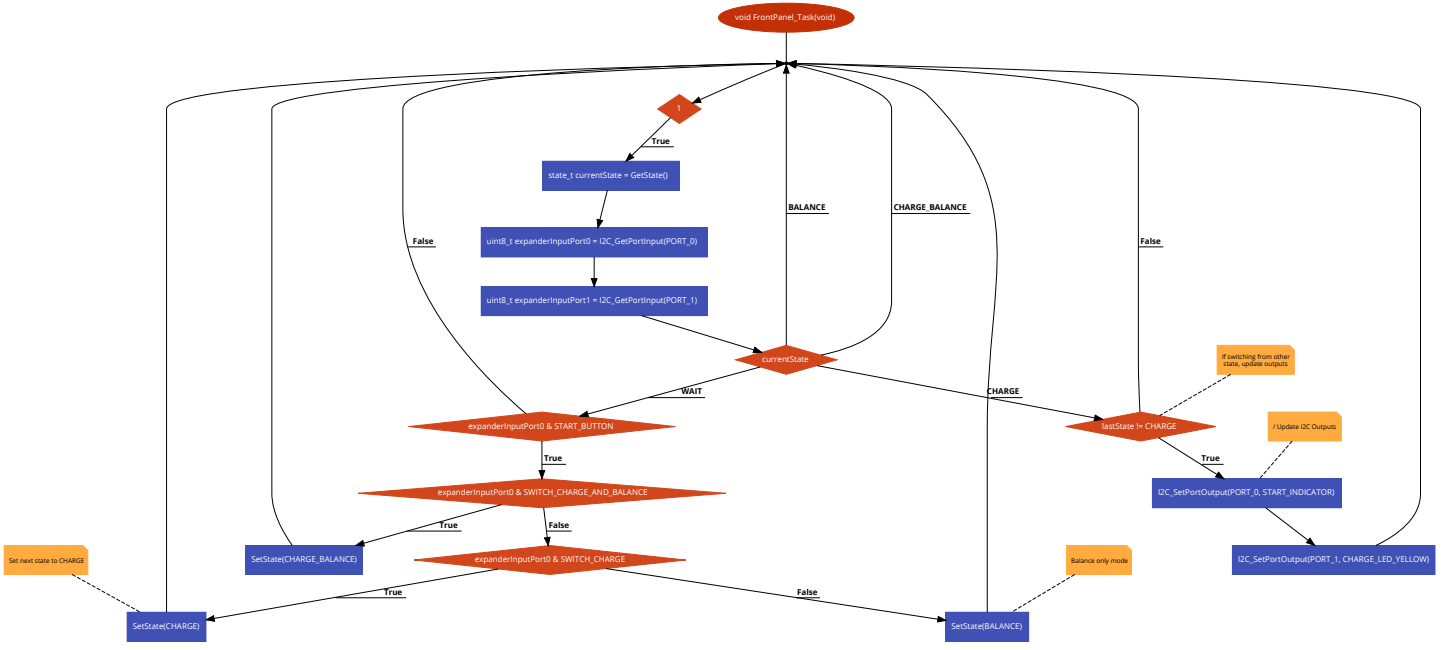
[picture p30: page 1]
void FrontPanel_Task(void); state_t currentState = GetState(); True; uint8_t expanderInputPort0 = I2C_GetPortInput(PORT_0); uint8_t expanderInputPort1 = I2C_GetPortInput(PORT_1); currentState; BALANCE; CHARGE_BALANCE; expanderInputPort0 & START_BUTTON; WAIT; lastState != CHARGE; CHARGE; False; expanderInputPort0 & SWITCH_CHARGE_AND_BALANCE; SetState(CHARGE_BALANCE); expanderInputPort0 & SWITCH_CHARGE; SetState(CHARGE); SetState(BALANCE); I2C_SetPortOutput(PORT_0, START_INDICATOR)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

If switching from other
state, update outputs
