tzarick/Battery-balancer/Software/Logic Flow Diagrams/GPIO.pdf

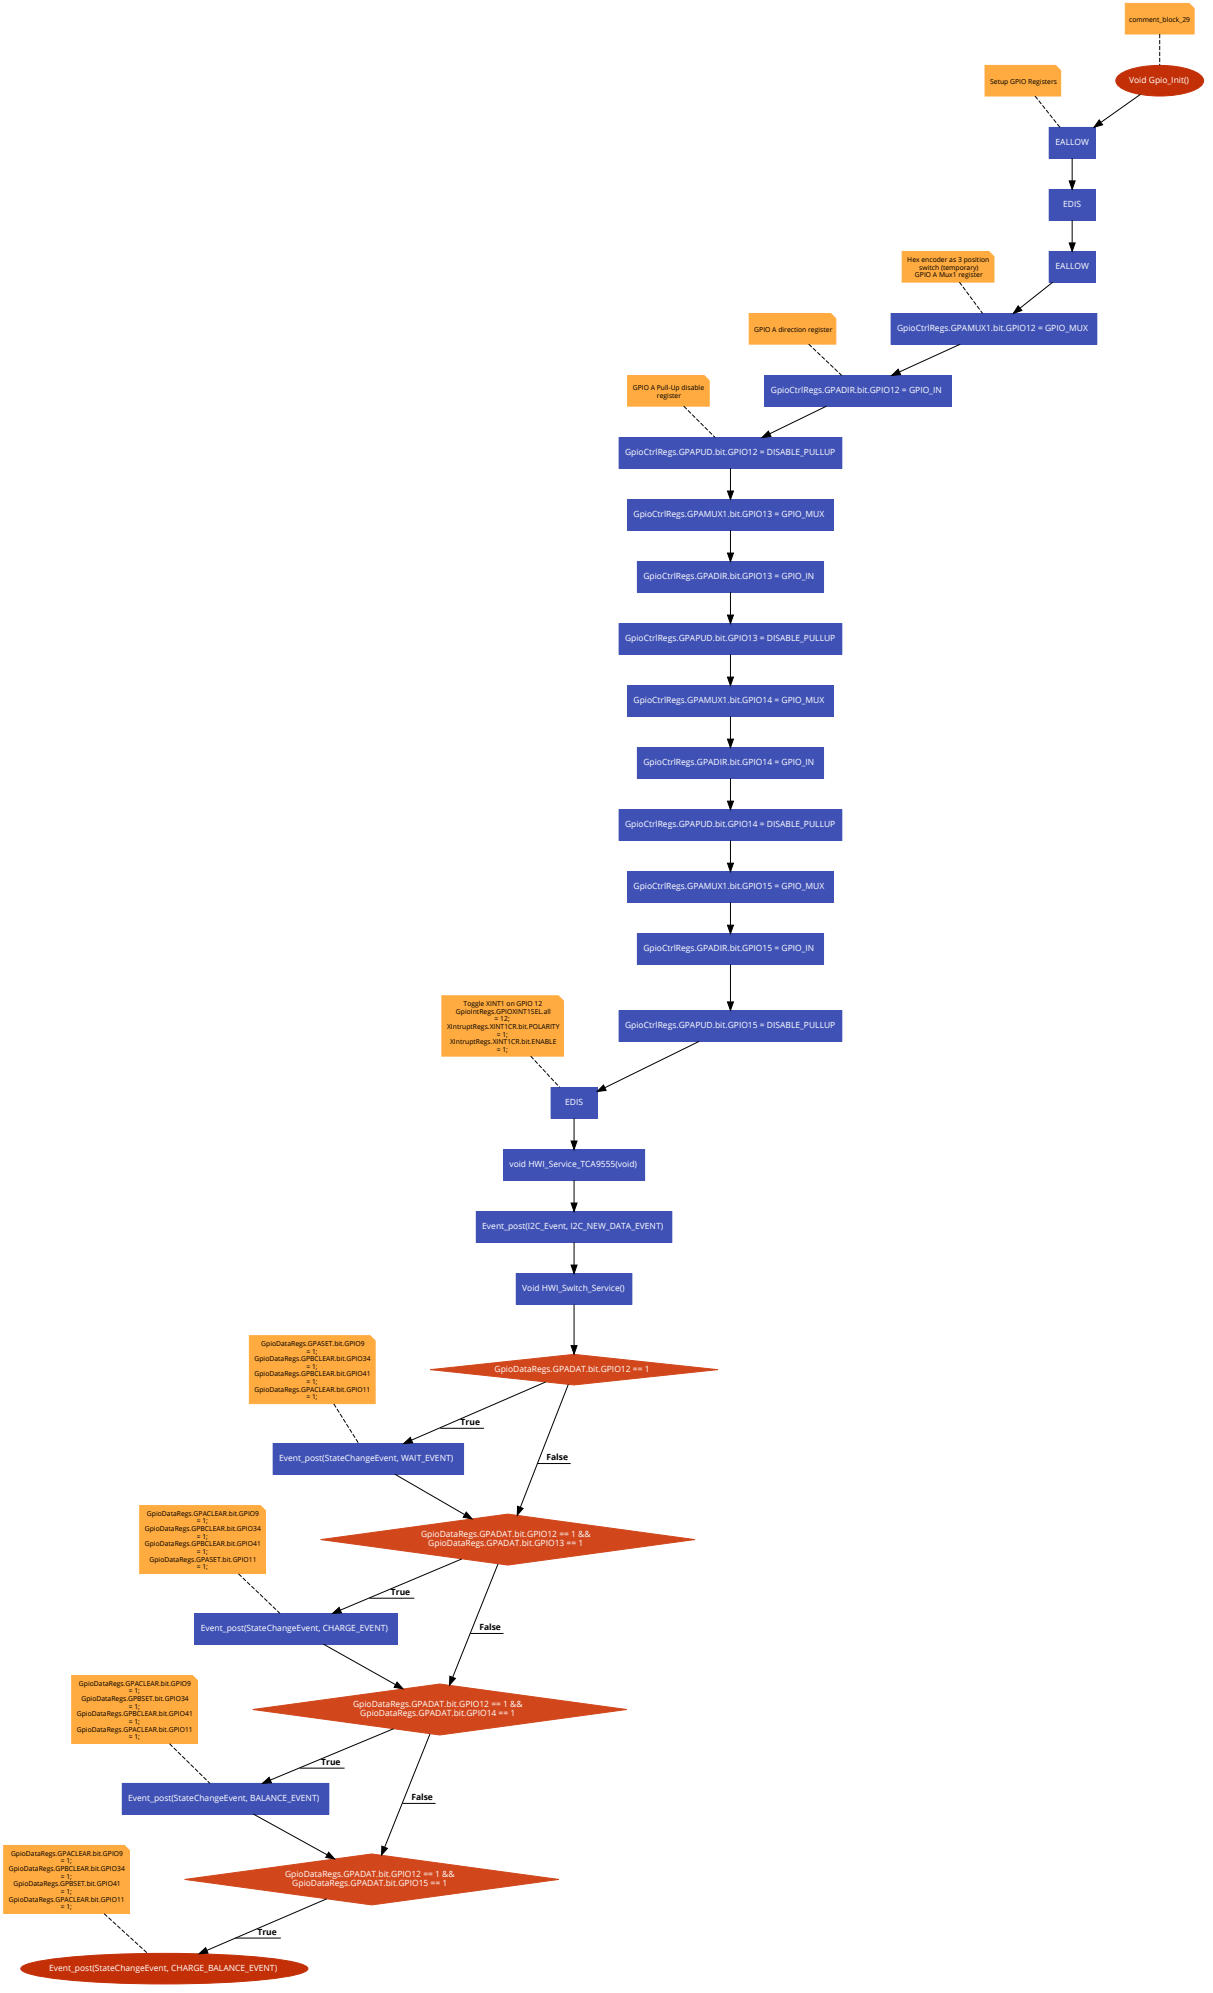
[picture p31: page 1]
Void Gpio_Init(); EALLOW; EDIS; GpioCtrlRegs.GPAMUX1.bit.GPIO12 = GPIO_MUX; GpioCtrlRegs.GPAMUX1.bit.GPIO13 = GPIO_MUX; GpioCtrlRegs.GPAMUX1.bit.GPIO14 = GPIO_MUX; GpioCtrlRegs.GPAMUX1.bit.GPIO15 = GPIO_MUX; void HWI_Service_TCA9555(void); Event_post(I2C_Event, I2C_NEW_DATA_EVENT); Void HWI_Switch_Service(); Event_post(StateChangeEvent, WAIT_EVENT); True; False; Event_post(StateChangeEvent, CHARGE_EVENT); Event_post(StateChangeEvent, BALANCE_EVENT)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

Setup GPIO Registers

Hex encoder as 3 position
switch (temporary)
GPIO A Mux1 register

GPIO A direction register

GPIO A Pull-Up disable
register

GpioCtrlRegs.GPADIR.bit.GPIO12 = GPIO_IN

GpioCtrlRegs.GPAPUD.bit.GPIO12 = DISABLE_PULLUP

GpioCtrlRegs.GPADIR.bit.GPIO13 = GPIO_IN

GpioCtrlRegs.GPAPUD.bit.GPIO13 = DISABLE_PULLUP

GpioCtrlRegs.GPADIR.bit.GPIO14 = GPIO_IN

GpioCtrlRegs.GPAPUD.bit.GPIO14 = DISABLE_PULLUP

GpioCtrlRegs.GPADIR.bit.GPIO15 = GPIO_IN

Toggle XINT1 on GPIO 12
GpioIntRegs.GPIOXINT1SEL.all
XIntruptRegs.XINT1CR.bit.POLARITY
XIntruptRegs.XINT1CR.bit.ENABLE

GpioCtrlRegs.GPAPUD.bit.GPIO15 = DISABLE_PULLUP

GpioDataRegs.GPASET.bit.GPIO9
GpioDataRegs.GPBCLEAR.bit.GPIO34
GpioDataRegs.GPBCLEAR.bit.GPIO41
GpioDataRegs.GPACLEAR.bit.GPIO11

GpioDataRegs.GPADAT.bit.GPIO12 == 1

GpioDataRegs.GPACLEAR.bit.GPIO9
GpioDataRegs.GPASET.bit.GPIO11

GpioDataRegs.GPADAT.bit.GPIO12 == 1 &&
GpioDataRegs.GPADAT.bit.GPIO13 == 1

GpioDataRegs.GPBSET.bit.GPIO34

GpioDataRegs.GPADAT.bit.GPIO14 == 1

GpioDataRegs.GPBSET.bit.GPIO41

GpioDataRegs.GPADAT.bit.GPIO15 == 1
