tzarick/Battery-balancer/Software/Logic Flow Diagrams/Initialize.pdf

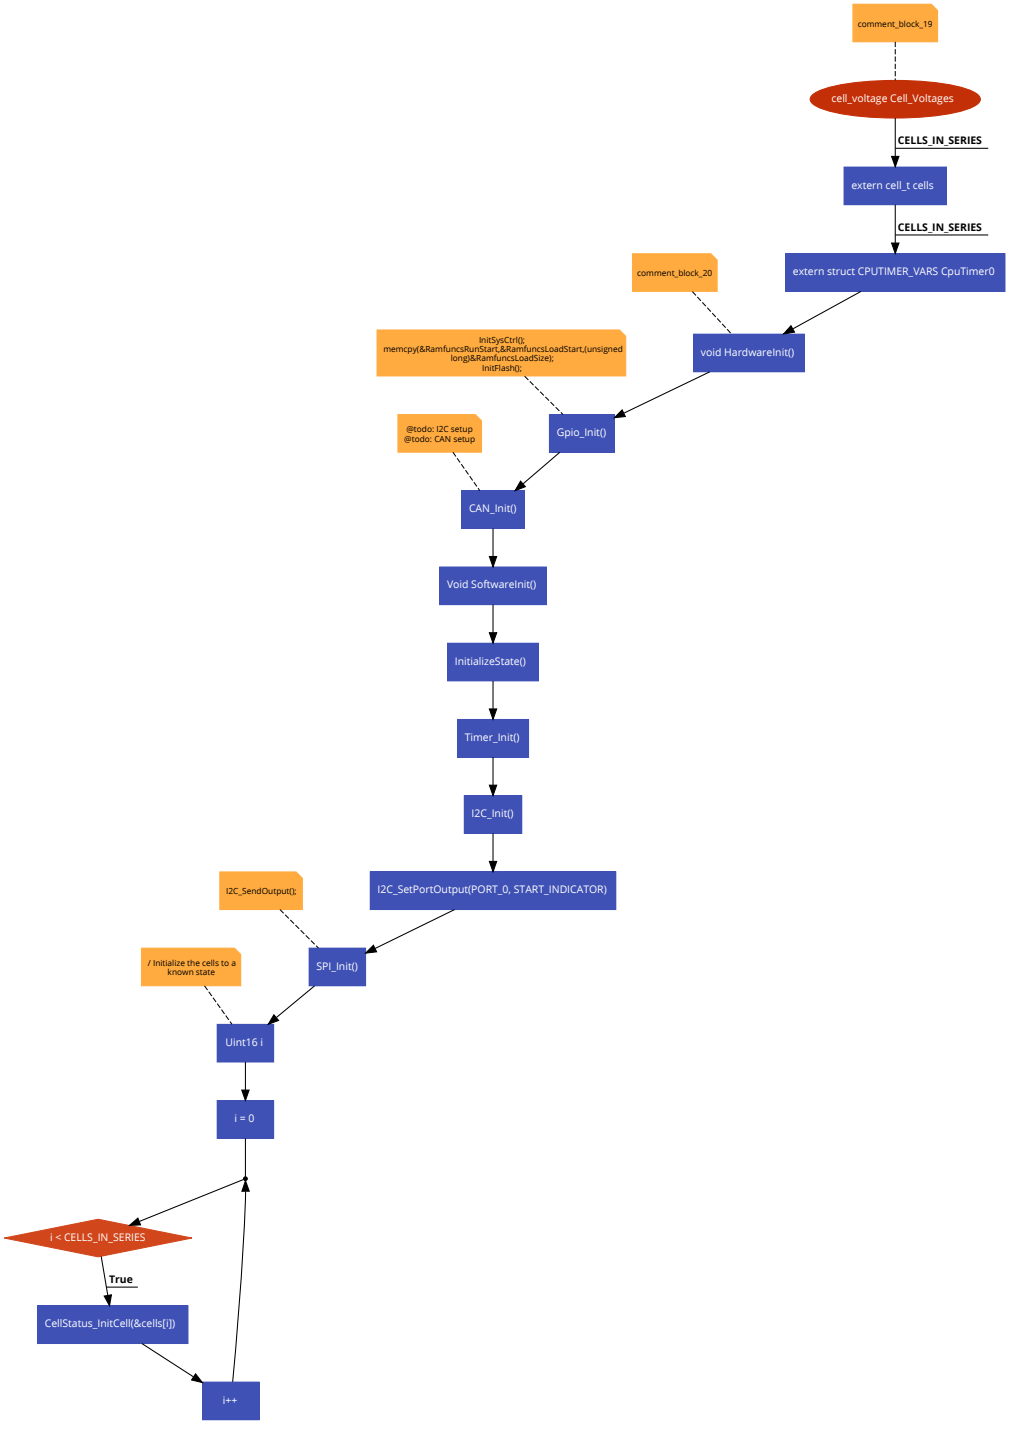
[picture p32: page 1]
cell_voltage Cell_Voltages; extern cell_t cells; CELLS_IN_SERIES; extern struct CPUTIMER_VARS CpuTimer0; void HardwareInit(); Gpio_Init(); CAN_Init(); Void SoftwareInit(); InitializeState(); Timer_Init(); I2C_Init(); I2C_SetPortOutput(PORT_0, START_INDICATOR); SPI_Init(); Uint16 i; i < CELLS_IN_SERIES; CellStatus_InitCell(&cells[i]); True; comment_block_19; comment_block_20; InitSysCtrl();; long)&RamfuncsLoadSize); InitFlash();; I2C_SendOutput();

memcpy(&RamfuncsRunStart,&RamfuncsLoadStart,(unsigned

@todo: I2C setup
@todo: CAN setup

/ Initialize the cells to a
known state
