tzarick/Battery-balancer/Software/Logic Flow Diagrams/Main.pdf

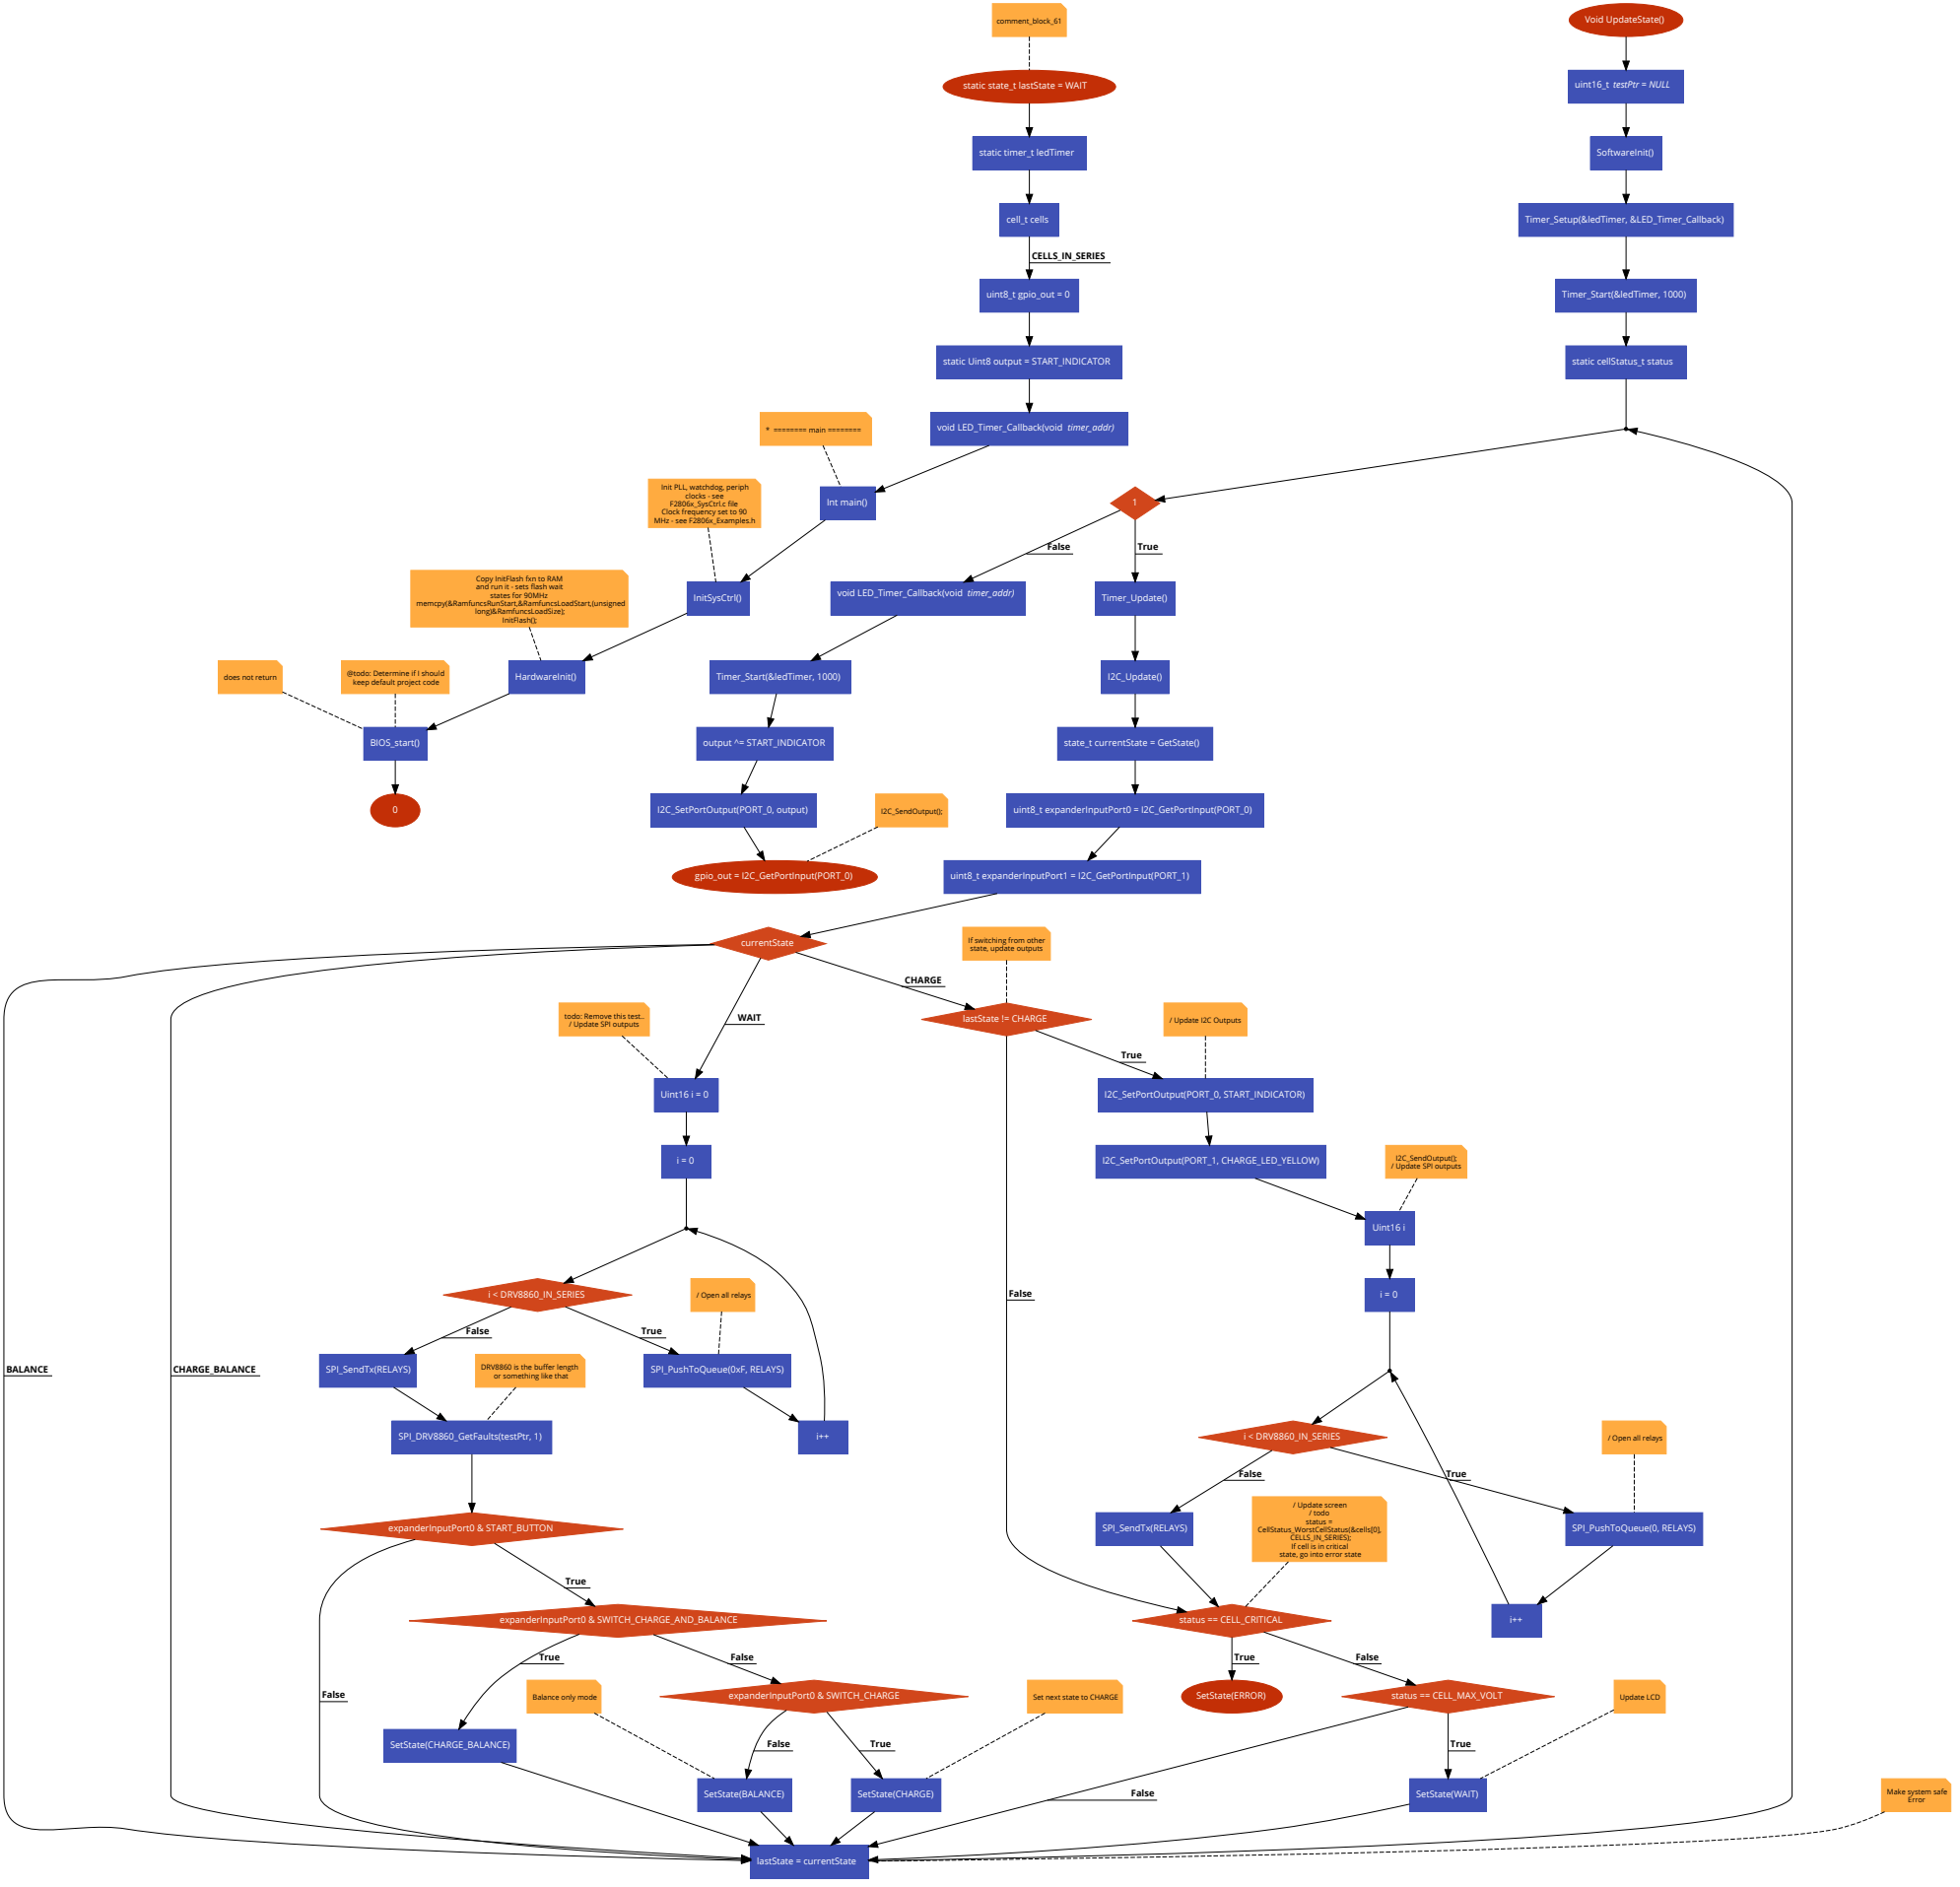
[picture p33: page 1]
static timer_t ledTimer; cell_t cells; uint8_t gpio_out = 0; CELLS_IN_SERIES; static Uint8 output = START_INDICATOR; void LED_Timer_Callback(void timer_addr); Int main(); InitSysCtrl(); HardwareInit(); BIOS_start(); Void UpdateState(); uint16_t testPtr = NULL; SoftwareInit(); Timer_Setup(&ledTimer, &LED_Timer_Callback); Timer_Start(&ledTimer, 1000); static cellStatus_t status; Timer_Update(); True; False; I2C_Update(); state_t currentState = GetState()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

static state_t lastState = WAIT

Init PLL, watchdog, periph
clocks - see
F2806x_SysCtrl.c file
Clock frequency set to 90
MHz - see F2806x_Examples.h

Copy InitFlash fxn to RAM
and run it - sets flash wait
states for 90MHz
long)&RamfuncsLoadSize);
InitFlash();

memcpy(&RamfuncsRunStart,&RamfuncsLoadStart,(unsigned

@todo: Determine if I should
keep default project code

does not return

If switching from other
state, update outputs

todo: Remove this test..
/ Update SPI outputs

I2C_SendOutput();

/ Open all relays

DRV8860 is the buffer length
or something like that

/ Update screen
/ todo
status =
CELLS_IN_SERIES);
If cell is in critical
state, go into error state

Make system safe
Error
