tzarick/Battery-balancer/Software/Logic Flow Diagrams/SPI.pdf

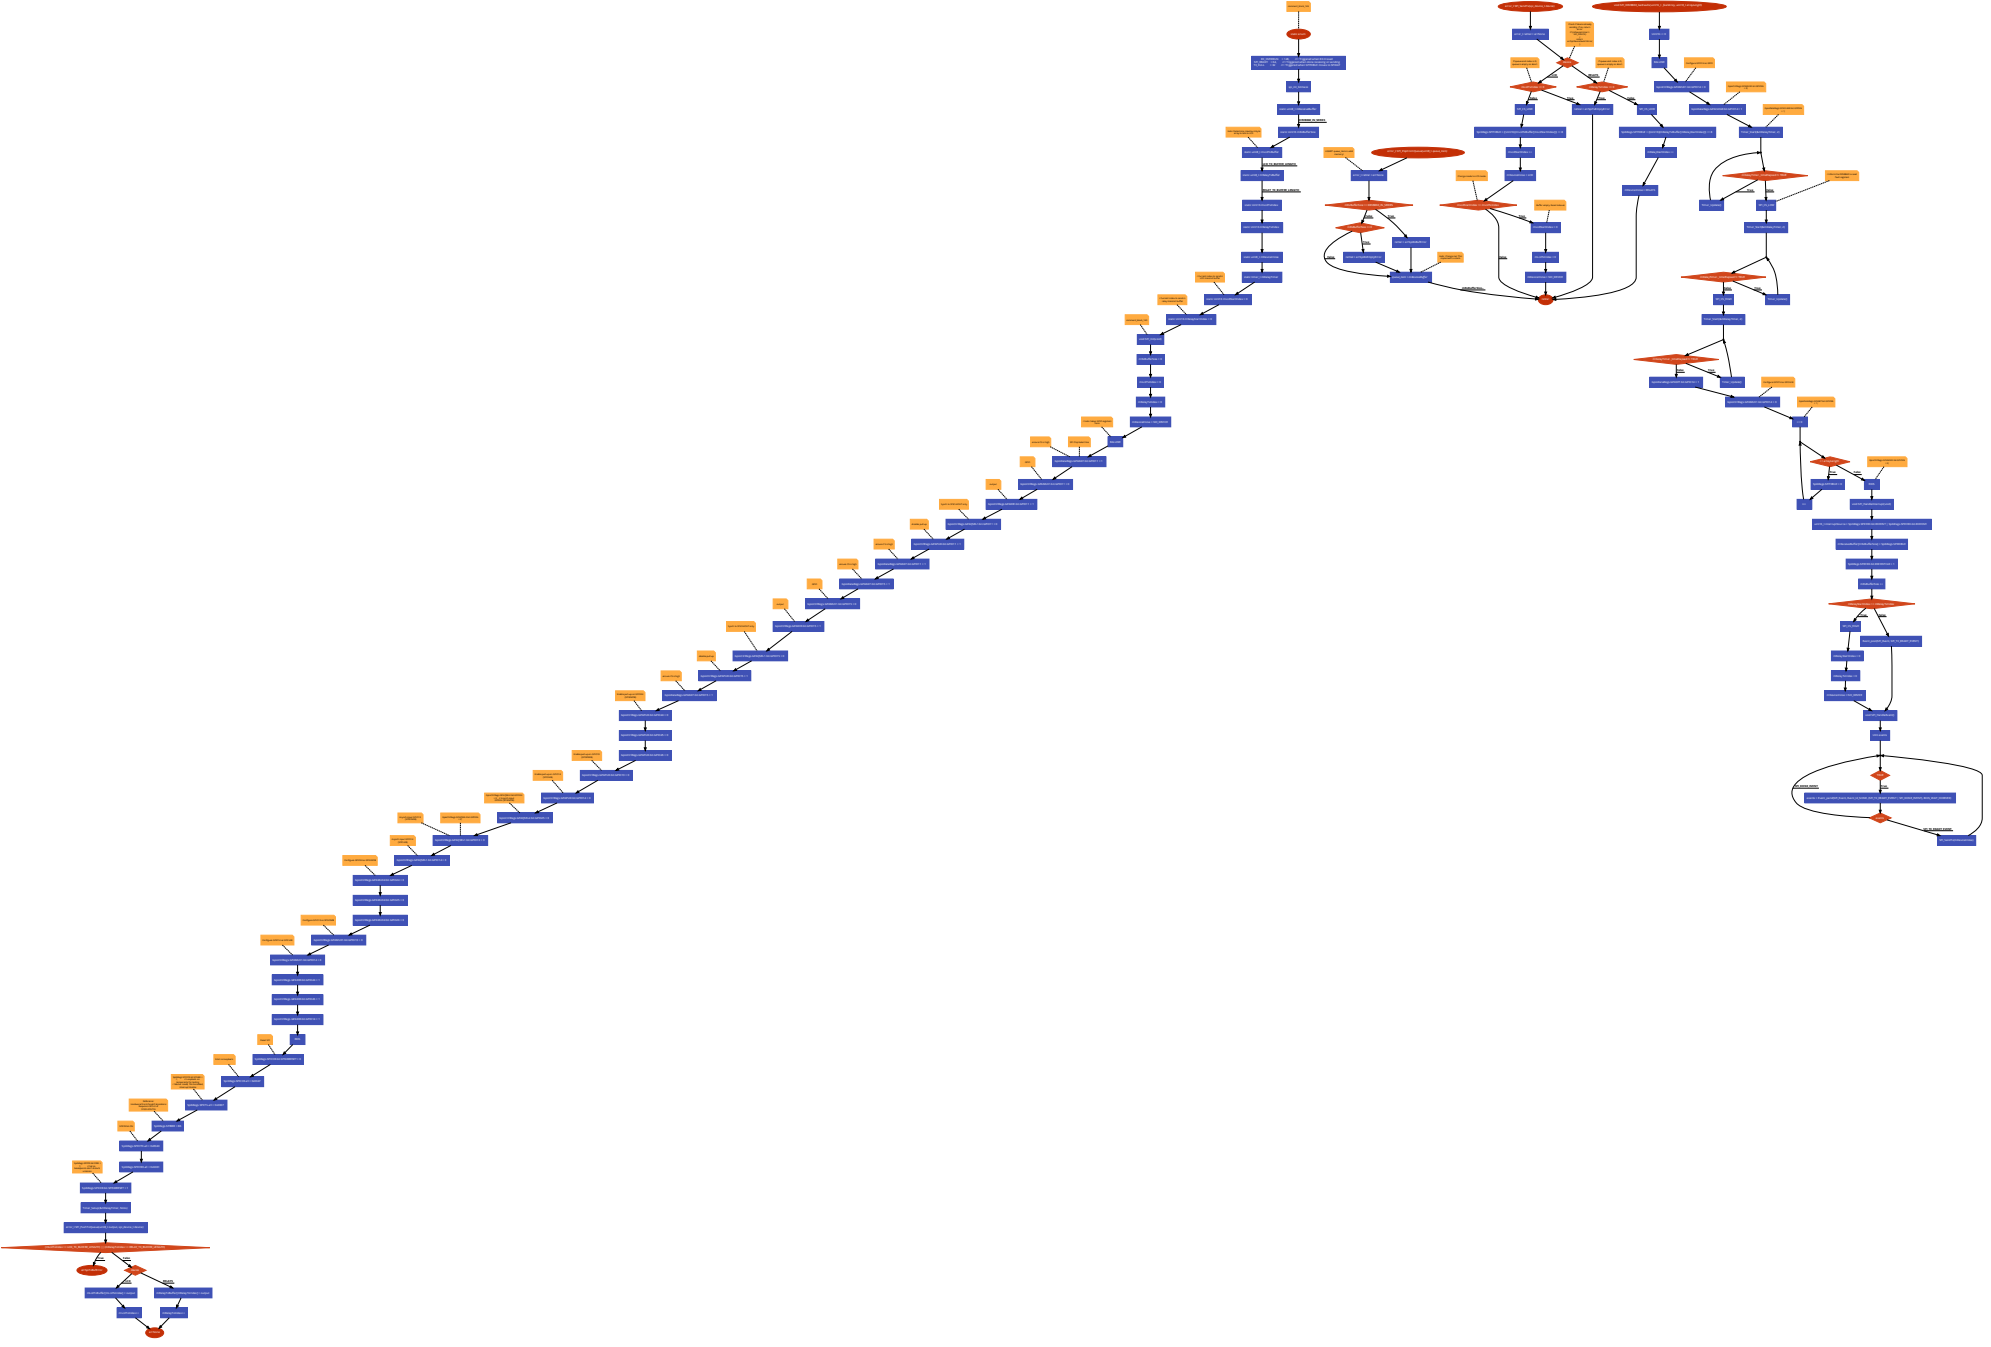
[picture p34: page 1]
static enum; RX_OVERRUN = 128,; //< Triggered when RX missed; SPI_READY = 64,; //< Triggered when done receiving or sending; TX_FULL; //< Triggered when SPITXBUF moves to SPIDAT; spi_int_bitmask; static uint8_t mReceiveBuffer; static Uint16 mRxBufferSize; DRV8860_IN_SERIES; static uint8_t mLcdTxBuffer; static uint8_t mRelayTxBuffer; LCD_TX_BUFFER_LENGTH; static Uint16 mLcdTxIndex; RELAY_TX_BUFFER_LENGTH; static Uint16 mRelayTxIndex; static uint8_t mDeviceInUse; static timer_t mDelayTimer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

void SPI_DRV8860_GetFaults(uint16_t faultArray, uint16_t arrayLength)

Check if device already
sending. If so, return

If queue end index is 0,
queue is empty so abort.

Configure GPIO14 as GPIO

GpioDataRegs.GPACLEAR.bit.GPIO14 = 1

GpioDataRegs.GPACLEAR.bit.GPIO26

todo: Determine maximum byte
array to talk to LCD

SpibRegs.SPITXBUF = ((Uint16)(mLcdTxBuffer[mLcdStartIndex])) << 8

SpibRegs.SPITXBUF = ((Uint16)(mRelayTxBuffer[mRelayStartIndex])) << 8

ASSERT queue_item is valid

Change mode to LCD mode.

/ Inform the DRV8860 to read

Buffer empty. Reset indexes

todo: Change me! This
implements a stack.

/ Current index to send in
LCD transmit buffer

relay transmit buffer

GpioDataRegs.GPASET.bit.GPIO14 = 1

Configure GPIO14 as SPICLKB

GpioDataRegs.GPASET.bit.GPIO26

/ todo: Setup GPIO registers

ensure CS is high

SPI Chip Select line

GpioDataRegs.GPADAT.bit.GPIO11 = 1

Synch to SYSCLKOUT only

GpioCtrlRegs.GPADIR.bit.GPIO11 = 1

disable pull up

uint16_t interruptSource = SpibRegs.SPIFFRX.bit.RXFFINT | SpibRegs.SPIFFRX.bit.RXFFOVF

GpioCtrlRegs.GPAPUD.bit.GPIO11 = 1

mReceiveBuffer[mRxBufferSize] = SpibRegs.SPIRXBUF

SpibRegs.SPIFFRX.bit.RXFFINTCLR = 1

GpioDataRegs.GPADAT.bit.GPIO15 = 1

GpioCtrlRegs.GPADIR.bit.GPIO15 = 1

GpioCtrlRegs.GPAPUD.bit.GPIO15 = 1

Enable pull-up on GPIO24

GpioCtrlRegs.GPAPUD.bit.GPIO24 = 0

GpioCtrlRegs.GPAPUD.bit.GPIO25 = 0

Enable pull-up on GPIO13

GpioCtrlRegs.GPAPUD.bit.GPIO26 = 0

Enable pull-up on GPIO14

GpioCtrlRegs.GPAPUD.bit.GPIO13 = 0

GpioCtrlRegs.GPAPUD.bit.GPIO14 = 0

Configure GPIO24 as SPISIMOB

Configure GPIO13 as SPISOMIB

GpioCtrlRegs.GPADIR.bit.GPIO24 = 1

GpioCtrlRegs.GPADIR.bit.GPIO26 = 1

GpioCtrlRegs.GPADIR.bit.GPIO14 = 1

8-bit no loopback

SpibRegs.SPICCR.bit.SPISWRESET = 0

SpibRegs.SPICCR.bit.SPILBK =
temporarily for testing
/ Master mode, TALK enabled,
Interrupt Enable

SpibRegs.SPICCR.all = 0x0047

Hardware/Front-Panel/Calculations

Requires LSPCLK of
SYSCLKOUT/6

SpibRegs.SPICTL.all = 0x0007

SpibRegs.SPIFFTX.all = 0xE040

SpibRegs.SPIPRI.bit.FREE =
breakpoints don't disturb

SpibRegs.SPIFFRX.all = 0x6061

SpibRegs.SPICCR.bit.SPISWRESET = 1

mLcdTxBuffer[mLcdTxIndex] = output

mRelayTxBuffer[mRelayTxIndex] = output
