tzarick/Battery-balancer/Software/Logic Flow Diagrams/Timer.pdf

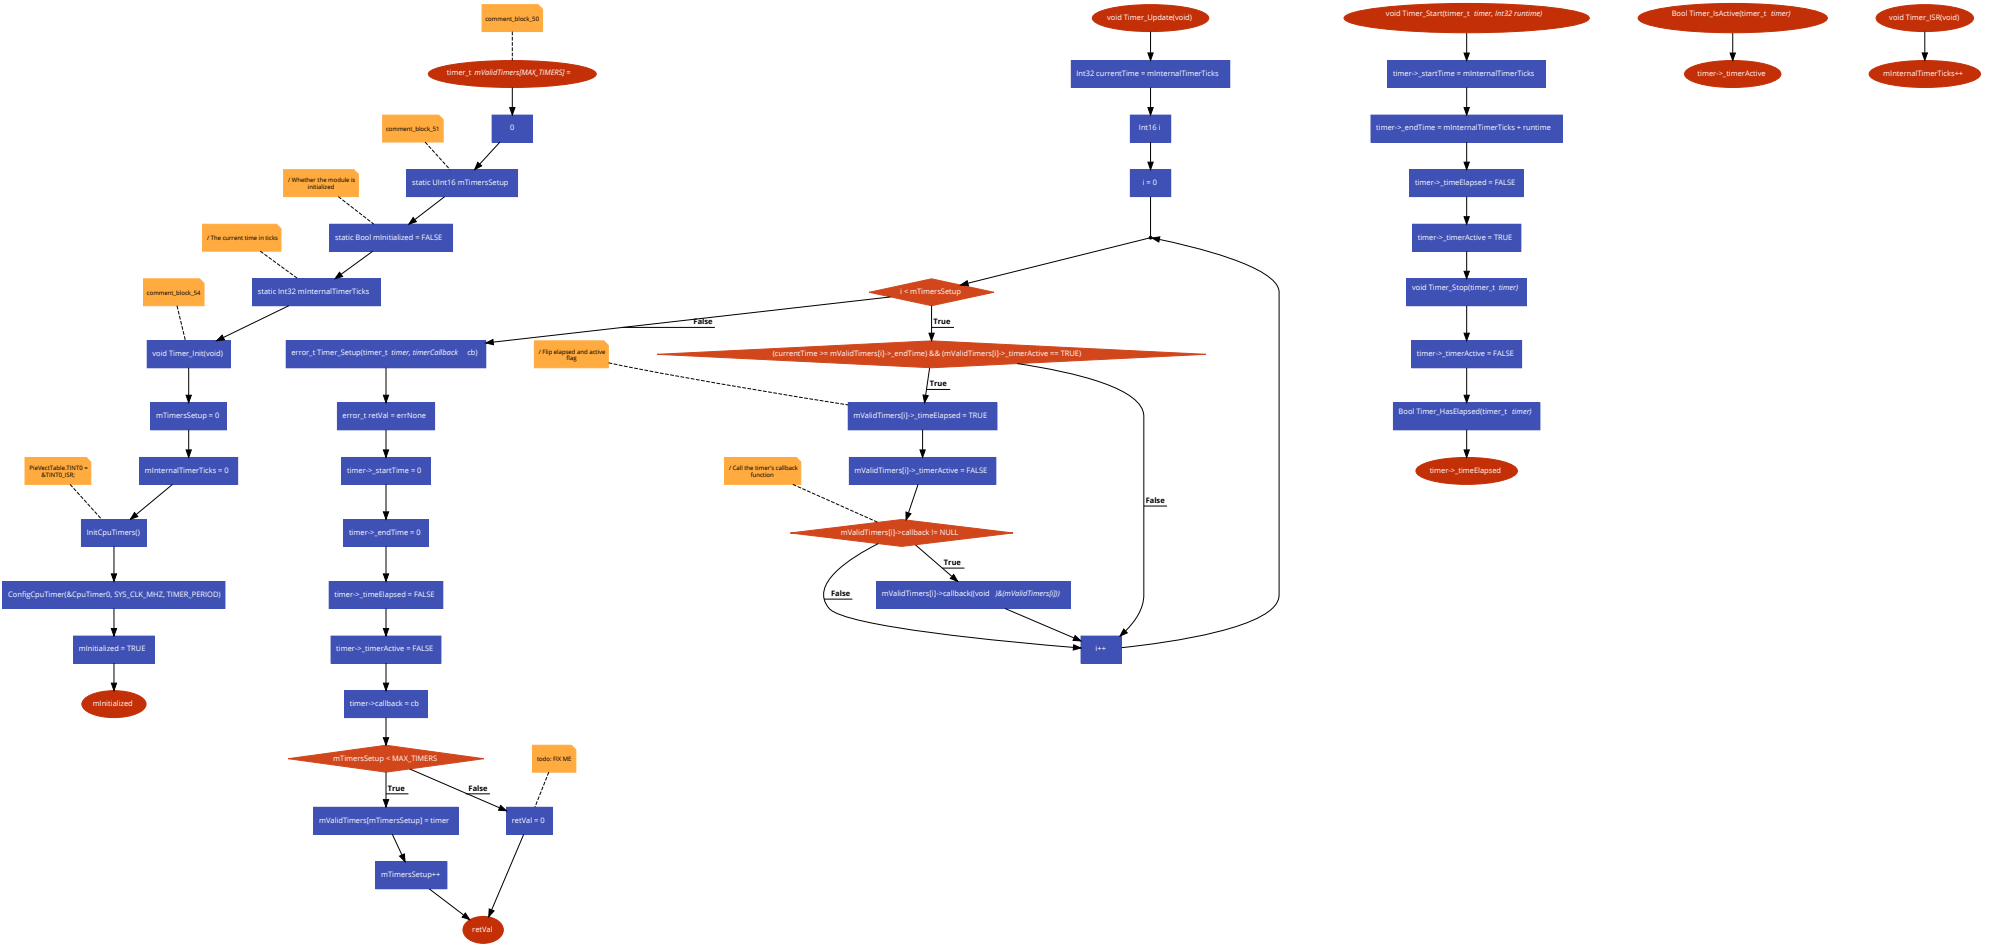
[picture p35: page 1]
timer_t mValidTimers[MAX_TIMERS] =; static UInt16 mTimersSetup; static Int32 mInternalTimerTicks; void Timer_Init(void); mTimersSetup = 0; mInternalTimerTicks = 0; InitCpuTimers(); ConfigCpuTimer(&CpuTimer0, SYS_CLK_MHZ, TIMER_PERIOD); mInitialized = TRUE; mInitialized; void Timer_Update(void); Int32 currentTime = mInternalTimerTicks; Int16 i; i < mTimersSetup; True; False; mValidTimers[i]->_timeElapsed = TRUE; mValidTimers[i]->_timerActive = FALSE; error_t retVal = errNone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

void Timer_Start(timer_t timer, Int32 runtime)

timer->_endTime = mInternalTimerTicks + runtime

/ Whether the module is
initialized

static Bool mInitialized = FALSE

/ The current time in ticks

error_t Timer_Setup(timer_t timer, timerCallback cb)

/ Flip elapsed and active

(currentTime >= mValidTimers[i]->_endTime) && (mValidTimers[i]->_timerActive == TRUE)

/ Call the timer's callback
function

mValidTimers[i]->callback != NULL

mValidTimers[i]->callback((void )&(mValidTimers[i]))

timer->callback = cb

todo: FIX ME

mValidTimers[mTimersSetup] = timer
