tzarick/Battery-balancer/Software/Logic Flow Diagrams/CAN/CAN_Init.pdf

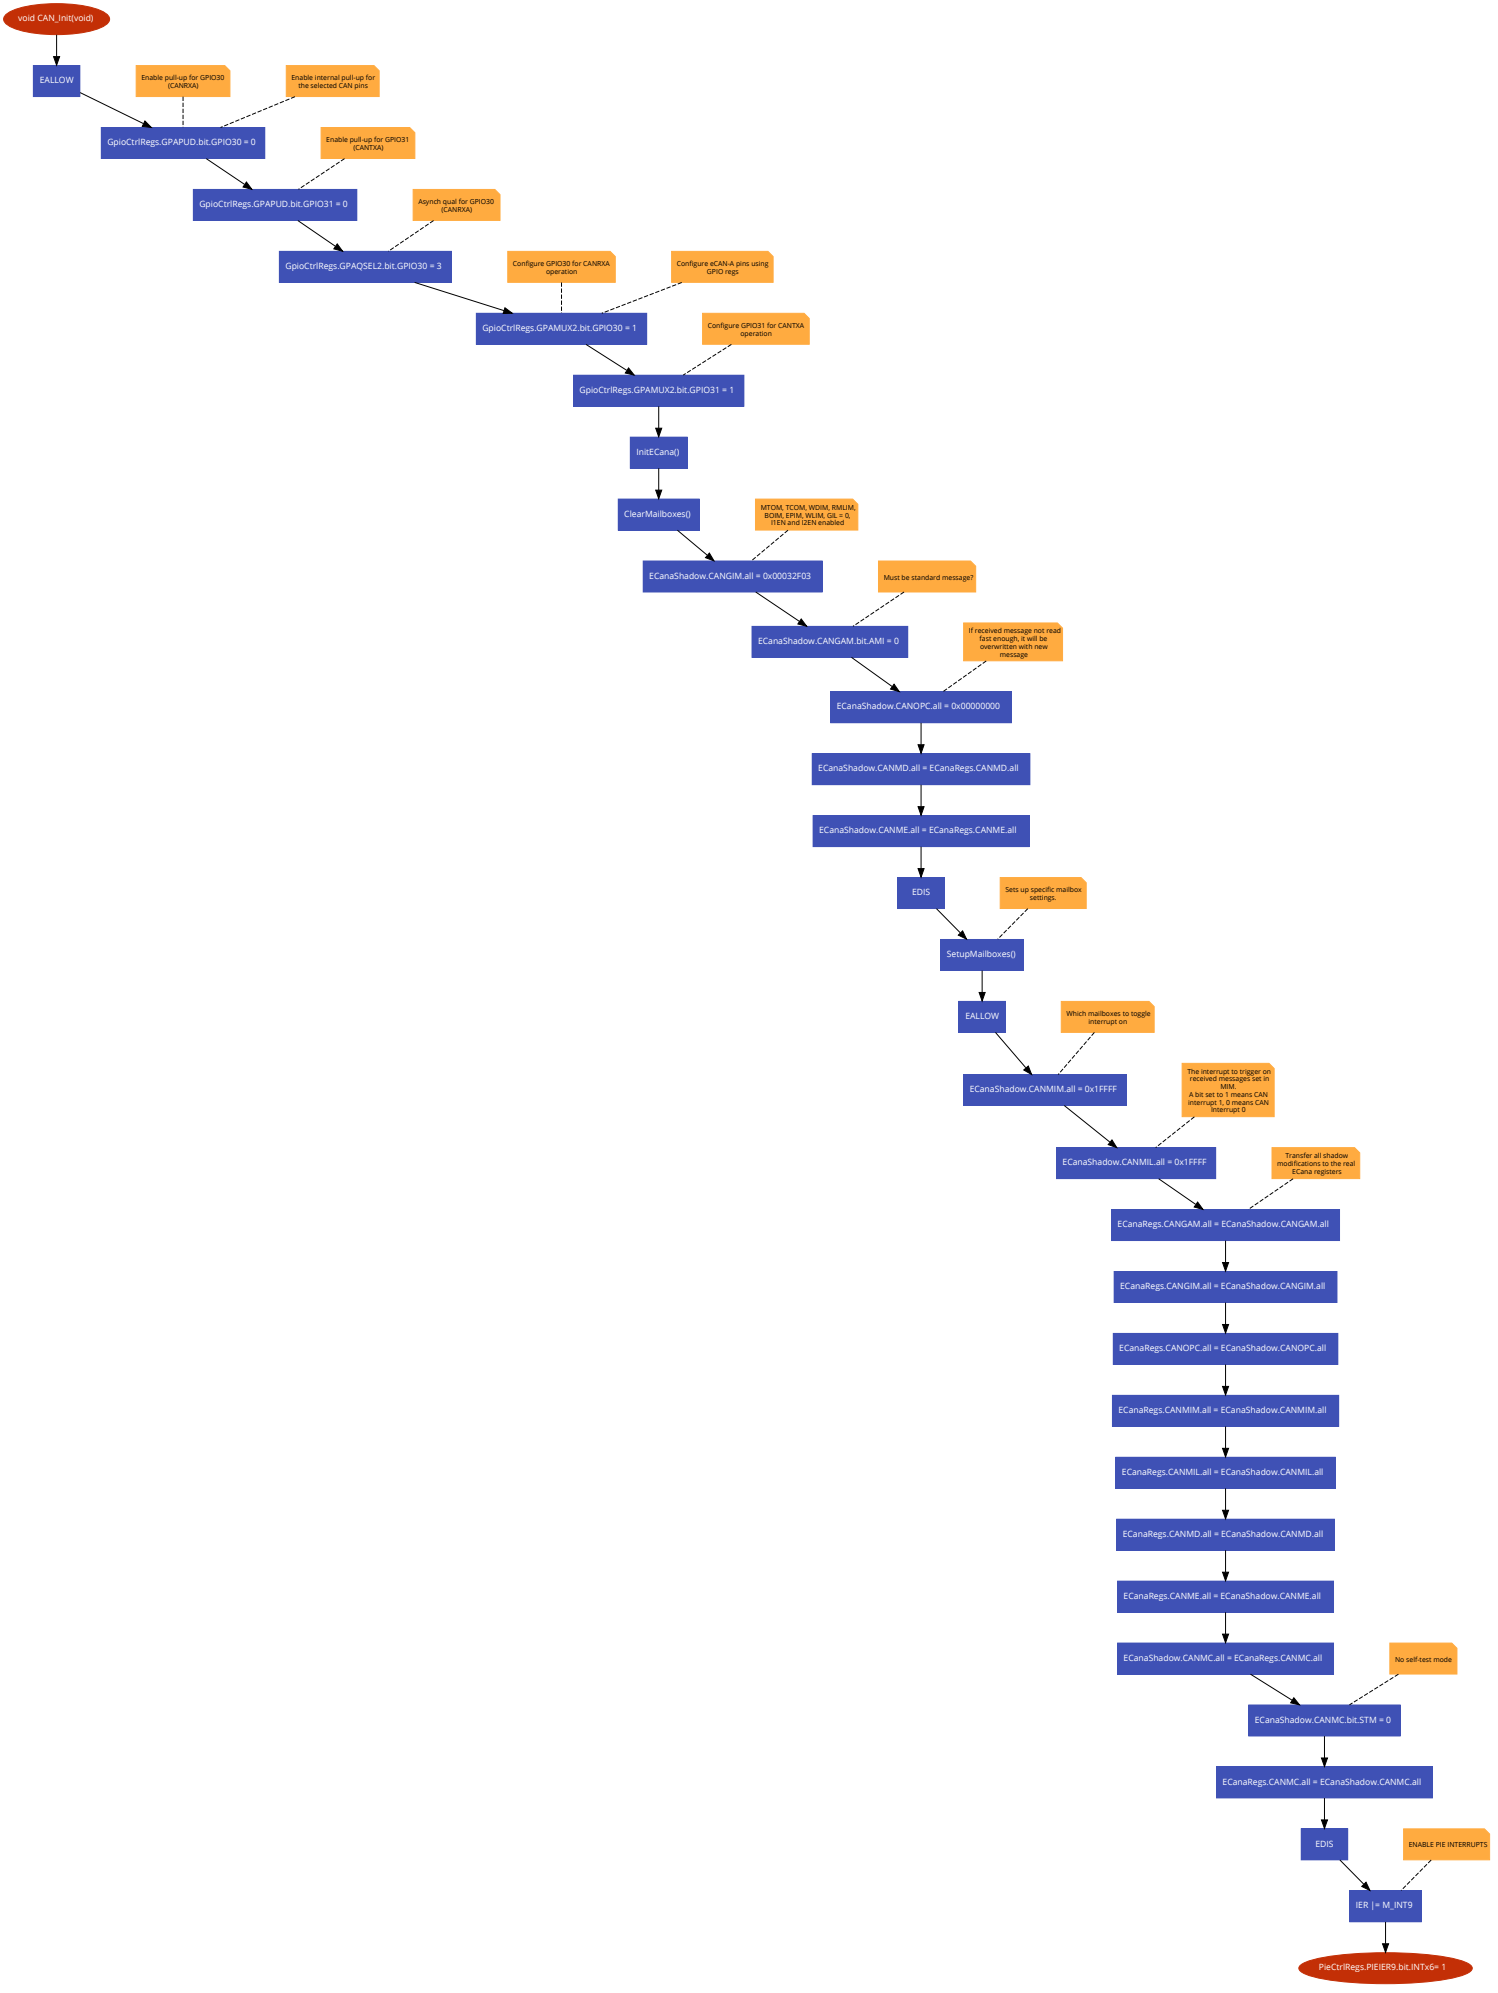
[picture p36: page 1]
void CAN_Init(void); EALLOW; GpioCtrlRegs.GPAQSEL2.bit.GPIO30 = 3; GpioCtrlRegs.GPAMUX2.bit.GPIO30 = 1; GpioCtrlRegs.GPAMUX2.bit.GPIO31 = 1; InitECana(); ClearMailboxes(); EDIS; SetupMailboxes(); IER |= M_INT9; PieCtrlRegs.PIEIER9.bit.INTx6= 1; operation; GPIO regs; MIM.

Enable pull-up for GPIO30
(CANRXA)

Enable internal pull-up for
the selected CAN pins

GpioCtrlRegs.GPAPUD.bit.GPIO30 = 0

Enable pull-up for GPIO31
(CANTXA)

GpioCtrlRegs.GPAPUD.bit.GPIO31 = 0

Asynch qual for GPIO30

Configure GPIO30 for CANRXA

Configure eCAN-A pins using

Configure GPIO31 for CANTXA

MTOM, TCOM, WDIM, RMLIM,
BOIM, EPIM, WLIM, GIL = 0,
I1EN and I2EN enabled

ECanaShadow.CANGIM.all = 0x00032F03

Must be standard message?

If received message not read
fast enough, it will be
overwritten with new
message

ECanaShadow.CANGAM.bit.AMI = 0

ECanaShadow.CANOPC.all = 0x00000000

ECanaShadow.CANMD.all = ECanaRegs.CANMD.all

ECanaShadow.CANME.all = ECanaRegs.CANME.all

Sets up specific mailbox
settings.

Which mailboxes to toggle
interrupt on

The interrupt to trigger on
received messages set in
A bit set to 1 means CAN
interrupt 1, 0 means CAN
Interrupt 0

ECanaShadow.CANMIM.all = 0x1FFFF

ECanaShadow.CANMIL.all = 0x1FFFF

Transfer all shadow
modifications to the real
ECana registers

ECanaRegs.CANGAM.all = ECanaShadow.CANGAM.all

ECanaRegs.CANGIM.all = ECanaShadow.CANGIM.all

ECanaRegs.CANOPC.all = ECanaShadow.CANOPC.all

ECanaRegs.CANMIM.all = ECanaShadow.CANMIM.all

ECanaRegs.CANMIL.all = ECanaShadow.CANMIL.all

ECanaRegs.CANMD.all = ECanaShadow.CANMD.all

ECanaRegs.CANME.all = ECanaShadow.CANME.all

ECanaShadow.CANMC.all = ECanaRegs.CANMC.all

No self-test mode

ECanaShadow.CANMC.bit.STM = 0

ECanaRegs.CANMC.all = ECanaShadow.CANMC.all

ENABLE PIE INTERRUPTS
