tzarick/Battery-balancer/Software/Logic Flow Diagrams/CAN/CAN_Receive_Interrupt.pdf

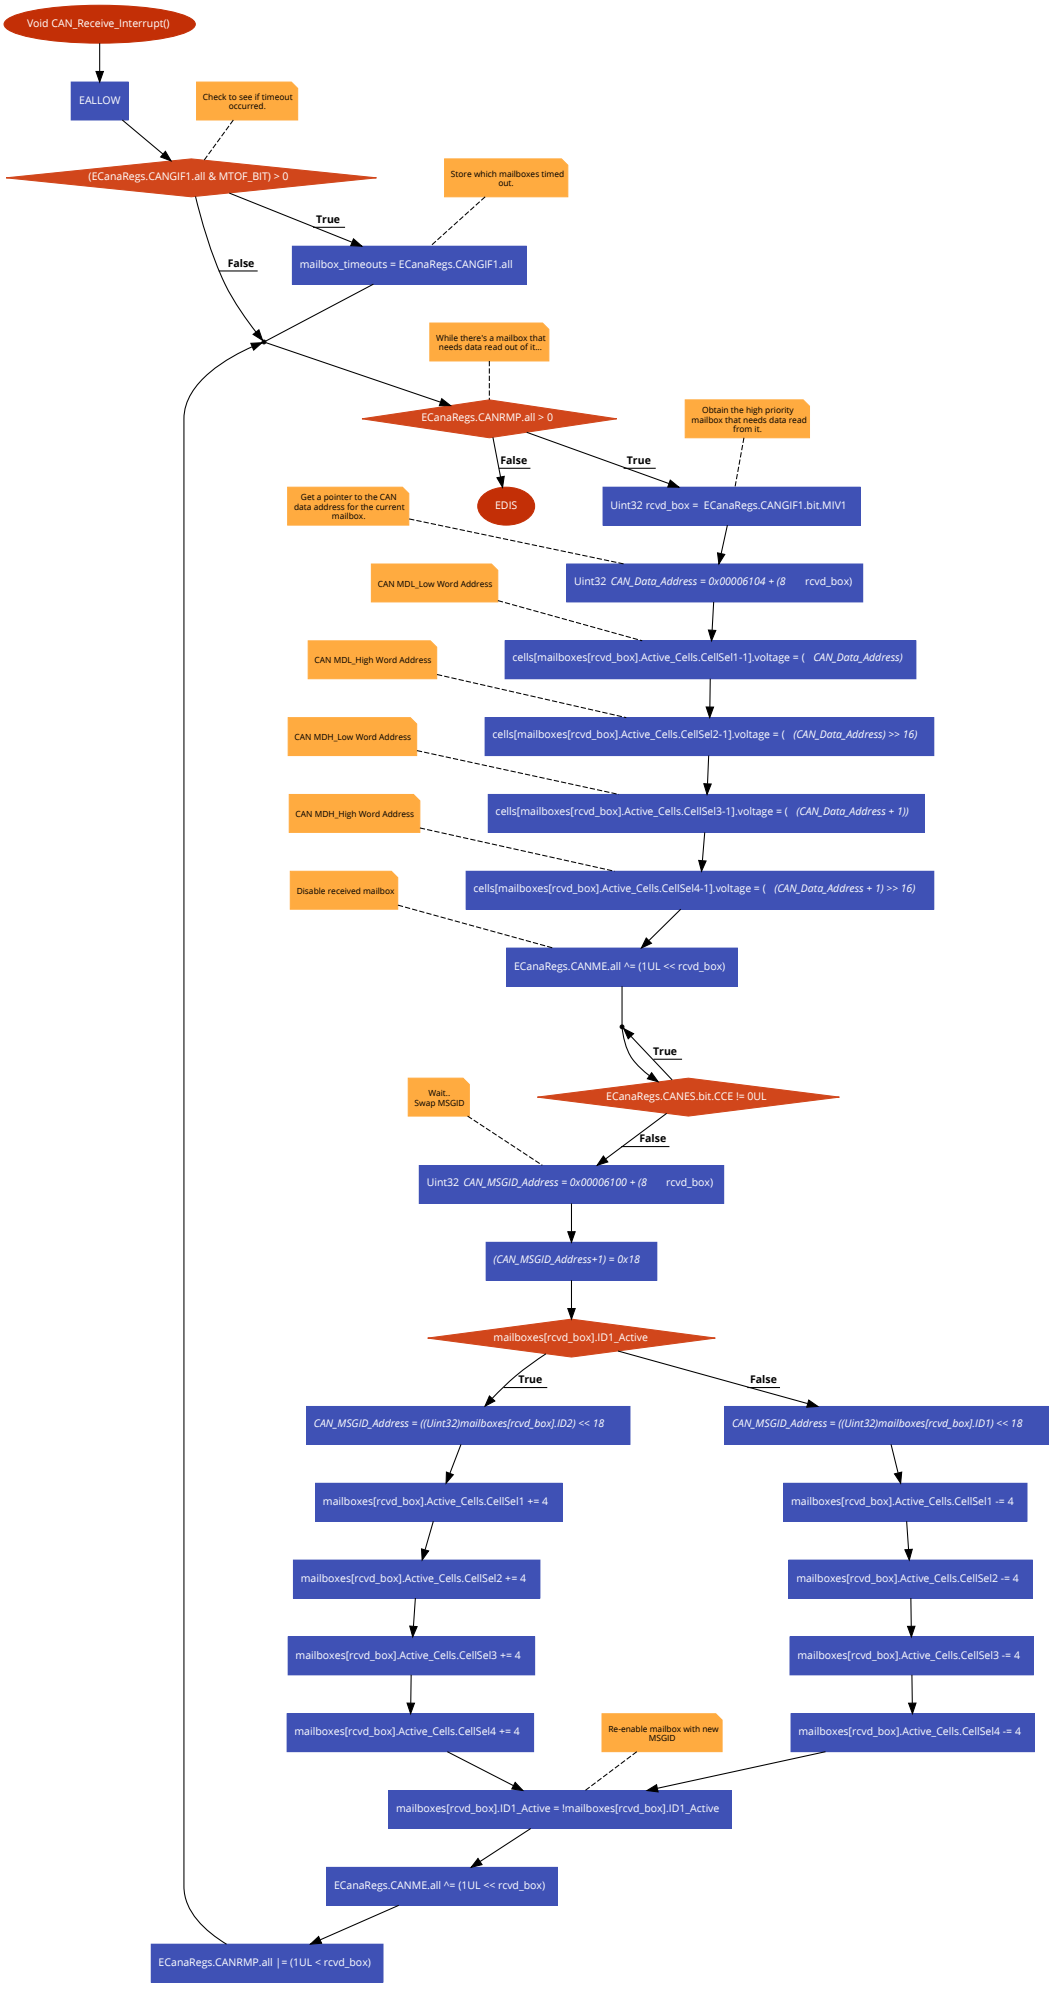
[picture p37: page 1]
Void CAN_Receive_Interrupt(); EALLOW; (ECanaRegs.CANGIF1.all & MTOF_BIT) > 0; mailbox_timeouts = ECanaRegs.CANGIF1.all; True; False; Uint32 rcvd_box = ECanaRegs.CANGIF1.bit.MIV1; EDIS; Uint32 CAN_Data_Address = 0x00006104 + (8; rcvd_box); Uint32 CAN_MSGID_Address = 0x00006100 + (8; (CAN_MSGID_Address+1) = 0x18; mailboxes[rcvd_box].ID1_Active; CAN_MSGID_Address = ((Uint32)mailboxes[rcvd_box].ID2) << 18; CAN_MSGID_Address = ((Uint32)mailboxes[rcvd_box].ID1) << 18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

Check to see if timeout
occurred.

Store which mailboxes timed

While there's a mailbox that
needs data read out of it...

ECanaRegs.CANRMP.all > 0

Obtain the high priority
mailbox that needs data read

Get a pointer to the CAN
data address for the current

CAN MDL_Low Word Address

CAN MDL_High Word Address

cells[mailboxes[rcvd_box].Active_Cells.CellSel1-1].voltage = ( CAN_Data_Address)

cells[mailboxes[rcvd_box].Active_Cells.CellSel2-1].voltage = ( (CAN_Data_Address) >> 16)

CAN MDH_Low Word Address

CAN MDH_High Word Address

cells[mailboxes[rcvd_box].Active_Cells.CellSel3-1].voltage = ( (CAN_Data_Address + 1))

Disable received mailbox

cells[mailboxes[rcvd_box].Active_Cells.CellSel4-1].voltage = ( (CAN_Data_Address + 1) >> 16)

ECanaRegs.CANME.all ^= (1UL << rcvd_box)

ECanaRegs.CANES.bit.CCE != 0UL

Re-enable mailbox with new

ECanaRegs.CANRMP.all |= (1UL < rcvd_box)
