tzarick/Battery-balancer/Software/Logic Flow Diagrams/I2C Coms/I2C Configure TCA9555 (I2C_Coms).pdf

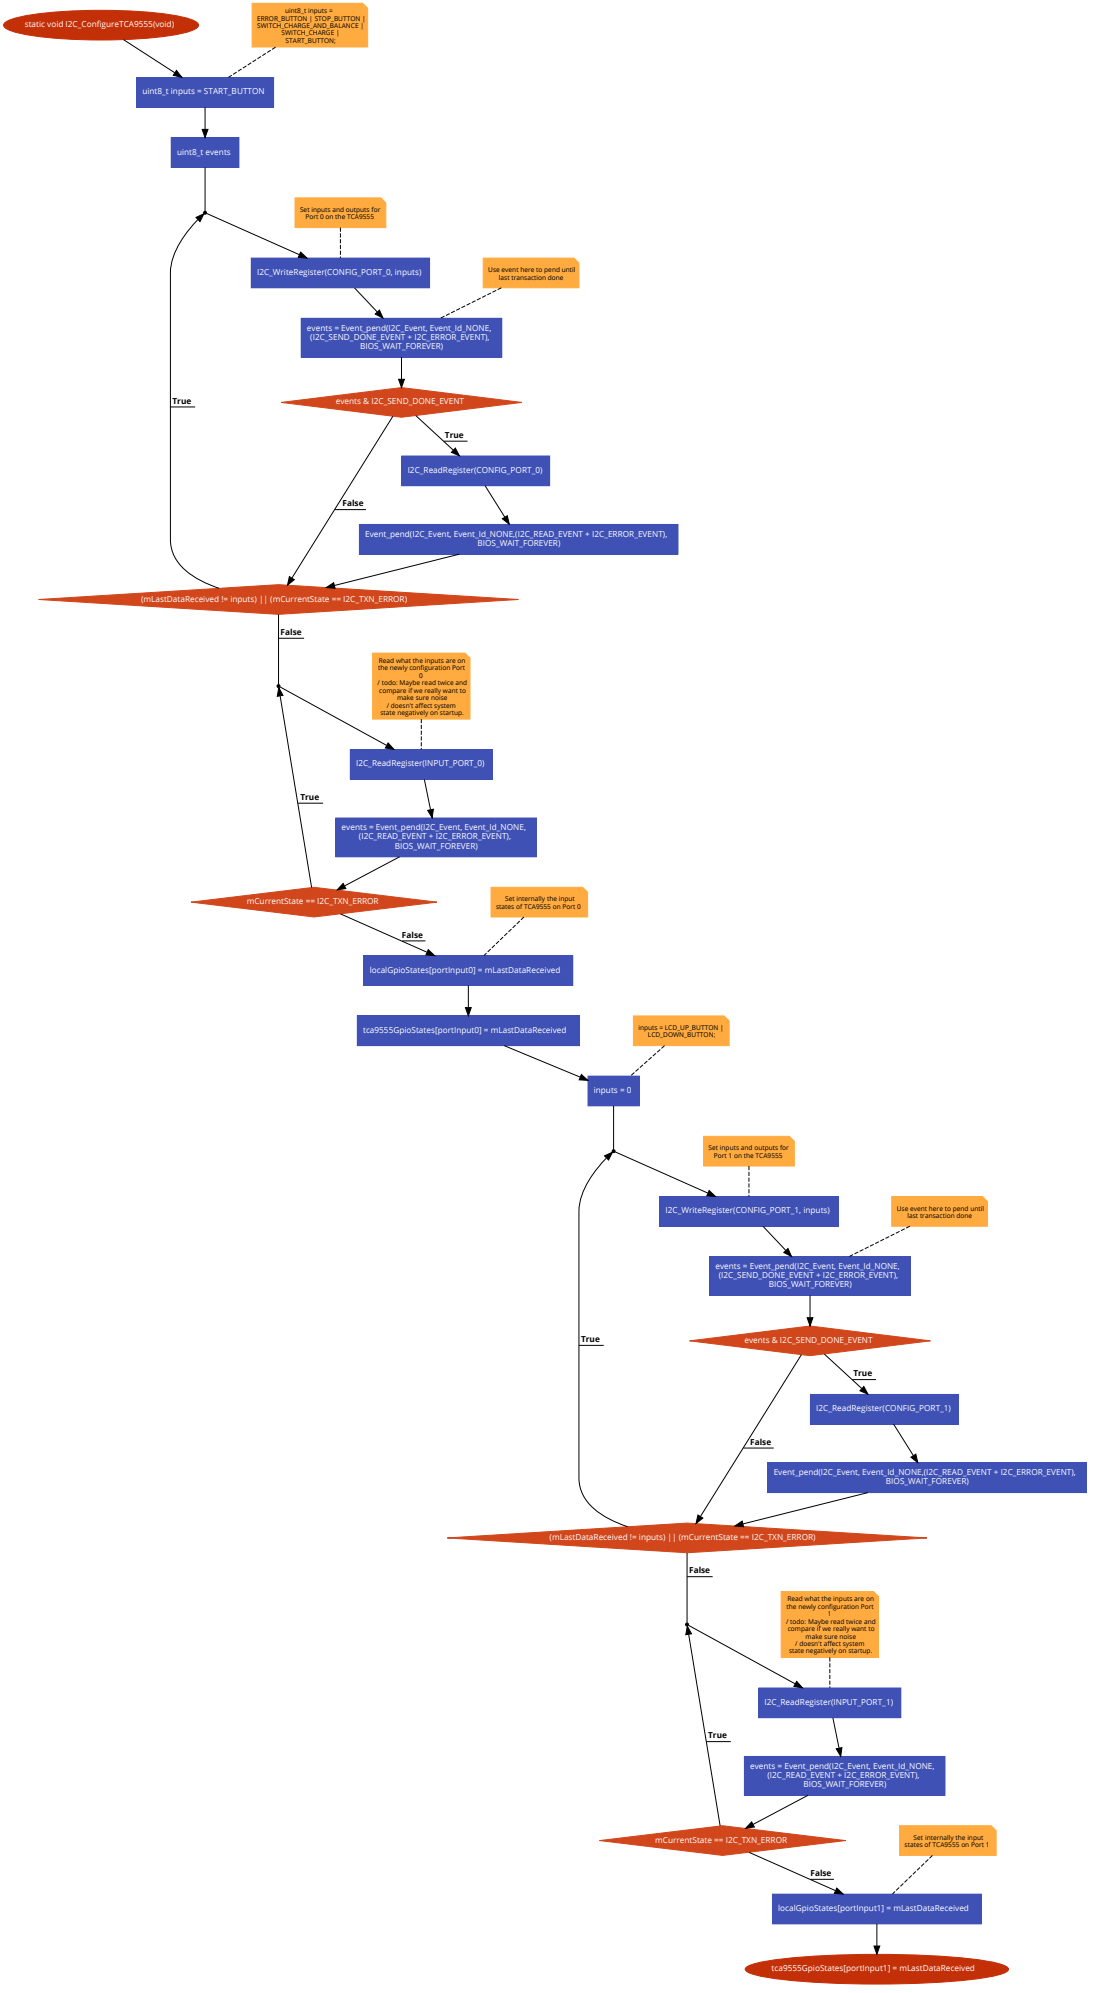
[picture p38: page 1]
uint8_t inputs = START_BUTTON; uint8_t events; I2C_WriteRegister(CONFIG_PORT_0, inputs); events = Event_pend(I2C_Event, Event_Id_NONE, (I2C_SEND_DONE_EVENT + I2C_ERROR_EVENT), BIOS_WAIT_FOREVER); events & I2C_SEND_DONE_EVENT; I2C_ReadRegister(CONFIG_PORT_0); True; False; Event_pend(I2C_Event, Event_Id_NONE,(I2C_READ_EVENT + I2C_ERROR_EVENT), BIOS_WAIT_FOREVER); I2C_ReadRegister(INPUT_PORT_0); events = Event_pend(I2C_Event, Event_Id_NONE, (I2C_READ_EVENT + I2C_ERROR_EVENT), BIOS_WAIT_FOREVER)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

static void I2C_ConfigureTCA9555(void)

Set inputs and outputs for
Port 0 on the TCA9555

Use event here to pend until
last transaction done

(mLastDataReceived != inputs) || (mCurrentState == I2C_TXN_ERROR)

Read what the inputs are on
the newly configuration Port
/ todo: Maybe read twice and
compare if we really want to
make sure noise
/ doesn't affect system
state negatively on startup.

Set internally the input
states of TCA9555 on Port 0

Port 1 on the TCA9555

states of TCA9555 on Port 1
