tzarick/Battery-balancer/Software/Logic Flow Diagrams/I2C Coms/I2C Interrupt (I2C Coms).pdf

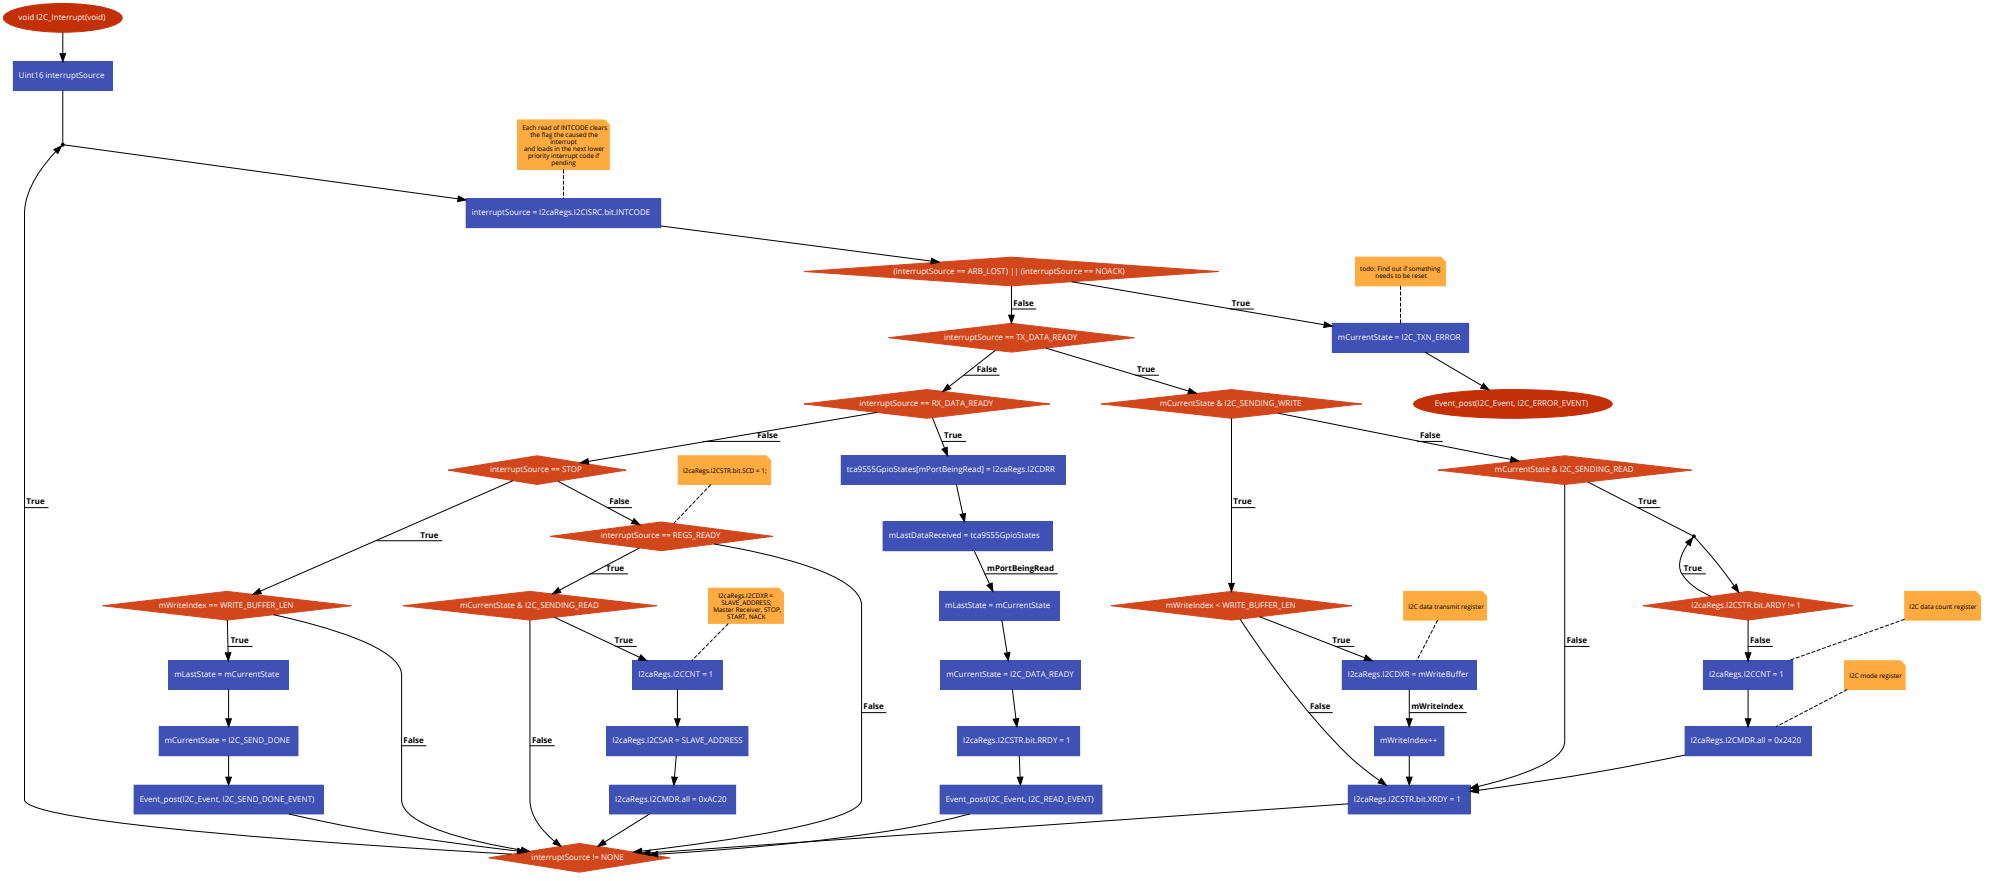
[picture p39: page 1]
void I2C_Interrupt(void); Uint16 interruptSource; mCurrentState = I2C_TXN_ERROR; True; interruptSource == TX_DATA_READY; False; mCurrentState & I2C_SENDING_WRITE; Event_post(I2C_Event, I2C_ERROR_EVENT); interruptSource == RX_DATA_READY; mWriteIndex < WRITE_BUFFER_LEN; mCurrentState & I2C_SENDING_READ; I2caRegs.I2CDXR = mWriteBuffer; I2caRegs.I2CSTR.bit.XRDY = 1; mWriteIndex++; mWriteIndex; I2caRegs.I2CSTR.bit.ARDY != 1; I2caRegs.I2CCNT = 1; I2caRegs.I2CMDR.all = 0x2420; interruptSource != NONE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

Each read of INTCODE clears
the flag the caused the
interrupt
priority interrupt code if
pending

and loads in the next lower

interruptSource = I2caRegs.I2CISRC.bit.INTCODE

(interruptSource == ARB_LOST) || (interruptSource == NOACK)

todo: Find out if something
needs to be reset
