tzarick/Battery-balancer/Software/Logic Flow Diagrams/I2C Coms/I2C Update (I2C_Coms).pdf

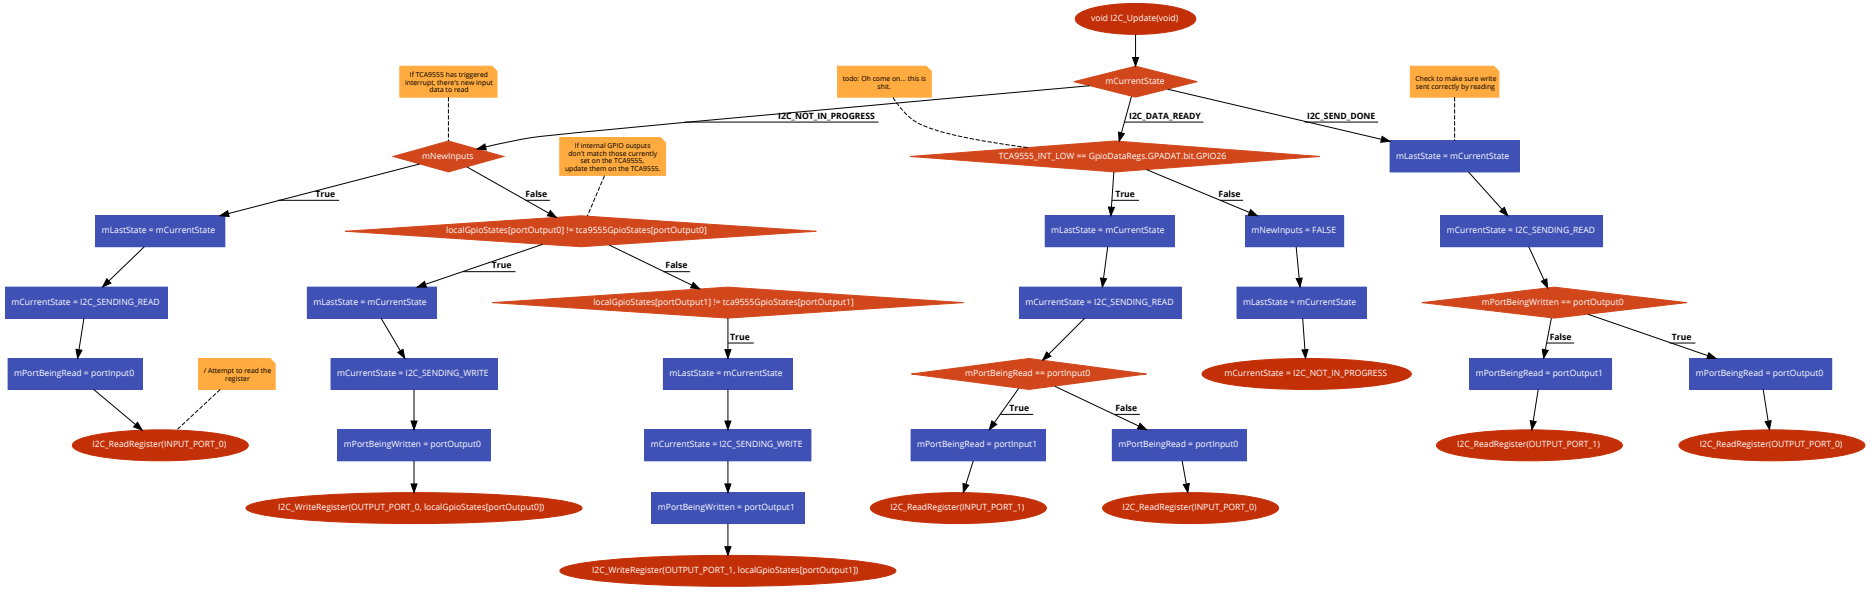
[picture p40: page 1]
void I2C_Update(void); mCurrentState; mNewInputs; I2C_NOT_IN_PROGRESS; I2C_DATA_READY; mLastState = mCurrentState; I2C_SEND_DONE; True; localGpioStates[portOutput0] != tca9555GpioStates[portOutput0]; False; mCurrentState = I2C_SENDING_READ; mPortBeingRead = portInput0; I2C_ReadRegister(INPUT_PORT_0); localGpioStates[portOutput1] != tca9555GpioStates[portOutput1]; mCurrentState = I2C_SENDING_WRITE; mPortBeingWritten = portOutput0; I2C_WriteRegister(OUTPUT_PORT_0, localGpioStates[portOutput0])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

If TCA9555 has triggered
interrupt, there's new input
data to read

todo: Oh come on... this is

Check to make sure write
sent correctly by reading

If internal GPIO outputs
don't match those currently
set on the TCA9555,
update them on the TCA9555.

TCA9555_INT_LOW == GpioDataRegs.GPADAT.bit.GPIO26

/ Attempt to read the
register
