tzarick/Battery-balancer/Software/Logic Flow Diagrams/I2C Coms/I2C_Init (I2C Coms).pdf

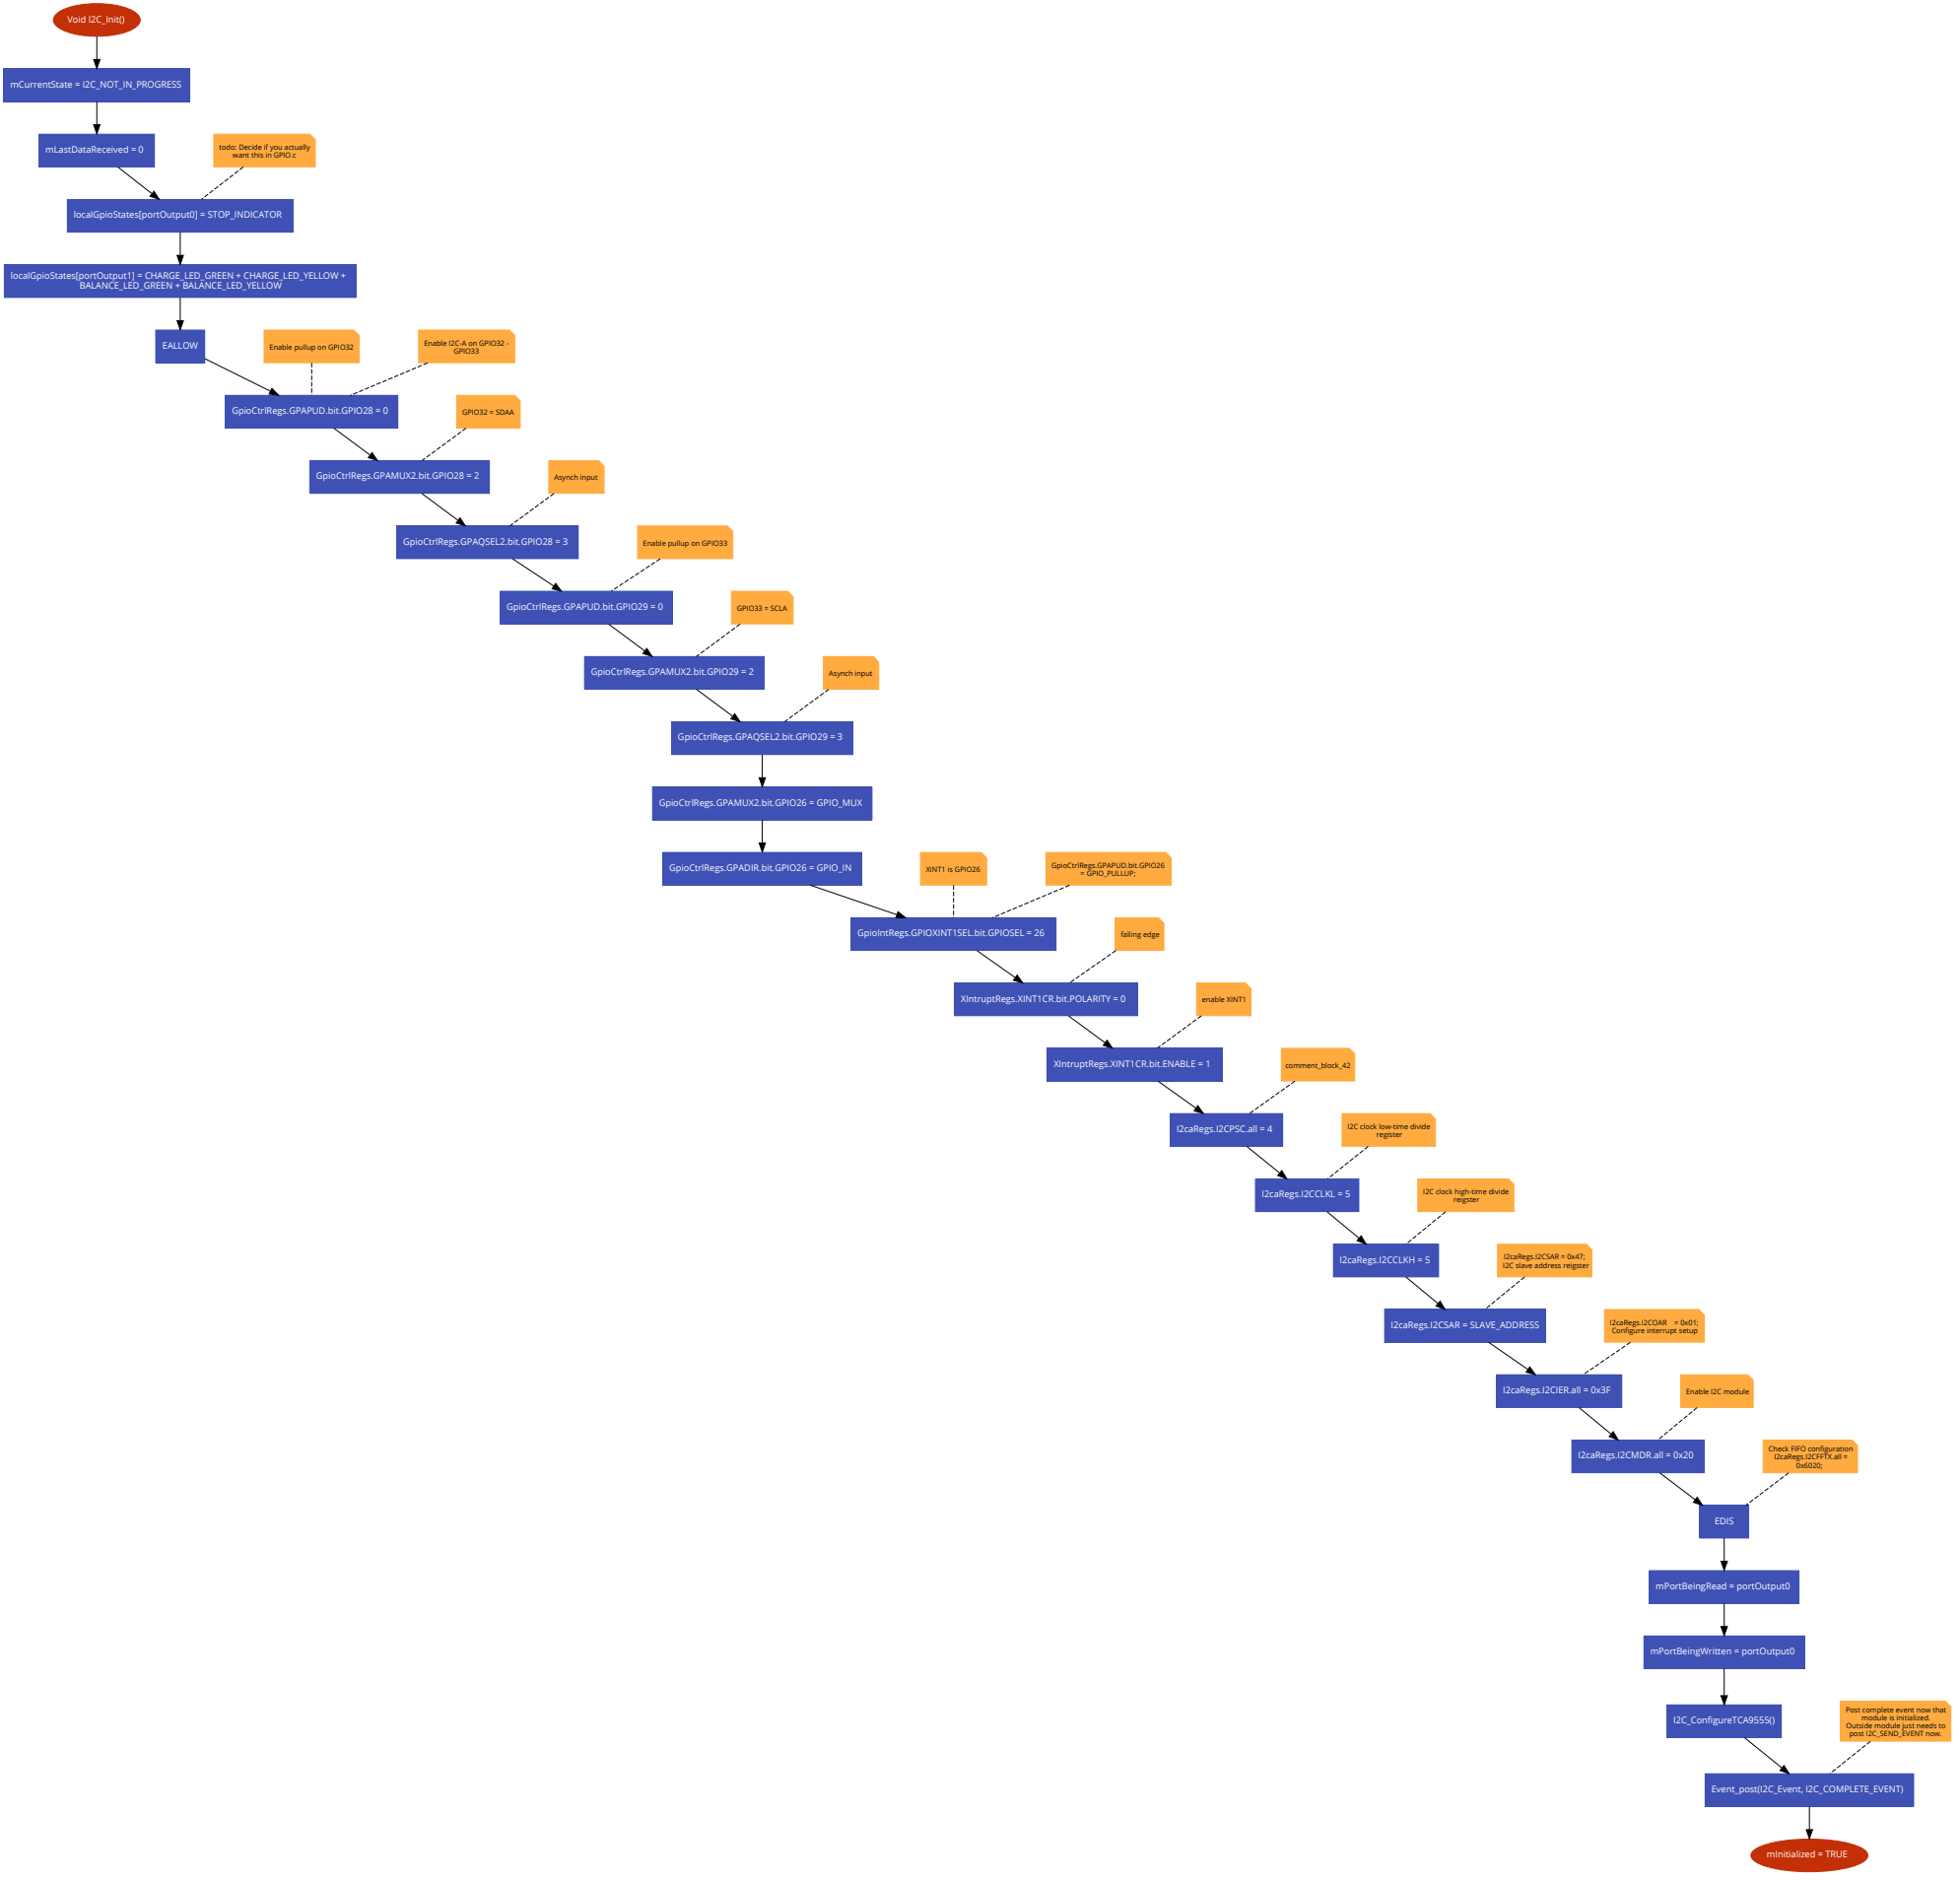
[picture p41: page 1]
Void I2C_Init(); mCurrentState = I2C_NOT_IN_PROGRESS; mLastDataReceived = 0; localGpioStates[portOutput0] = STOP_INDICATOR; localGpioStates[portOutput1] = CHARGE_LED_GREEN + CHARGE_LED_YELLOW + BALANCE_LED_GREEN + BALANCE_LED_YELLOW; EALLOW; GpioCtrlRegs.GPAMUX2.bit.GPIO28 = 2; GpioCtrlRegs.GPAQSEL2.bit.GPIO28 = 3; GpioCtrlRegs.GPAMUX2.bit.GPIO29 = 2; GpioCtrlRegs.GPAQSEL2.bit.GPIO29 = 3; GpioCtrlRegs.GPAMUX2.bit.GPIO26 = GPIO_MUX; I2caRegs.I2CPSC.all = 4; I2caRegs.I2CCLKL = 5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

todo: Decide if you actually
want this in GPIO.c

Enable pullup on GPIO32

GpioCtrlRegs.GPAPUD.bit.GPIO28 = 0

Enable pullup on GPIO33

GpioCtrlRegs.GPAPUD.bit.GPIO29 = 0

GpioCtrlRegs.GPADIR.bit.GPIO26 = GPIO_IN

GpioCtrlRegs.GPAPUD.bit.GPIO26

GpioIntRegs.GPIOXINT1SEL.bit.GPIOSEL = 26

XIntruptRegs.XINT1CR.bit.POLARITY = 0

XIntruptRegs.XINT1CR.bit.ENABLE = 1

I2C clock low-time divide

I2C clock high-time divide

I2caRegs.I2CSAR = 0x47;
I2C slave address reigster

I2caRegs.I2COAR = 0x01;
Configure interrupt setup

Post complete event now that
module is initialized.
Outside module just needs to
post I2C_SEND_EVENT now.
