tzarick/Battery-balancer/Hardware/RelayBoard/RelayBoard - bottom.pdf

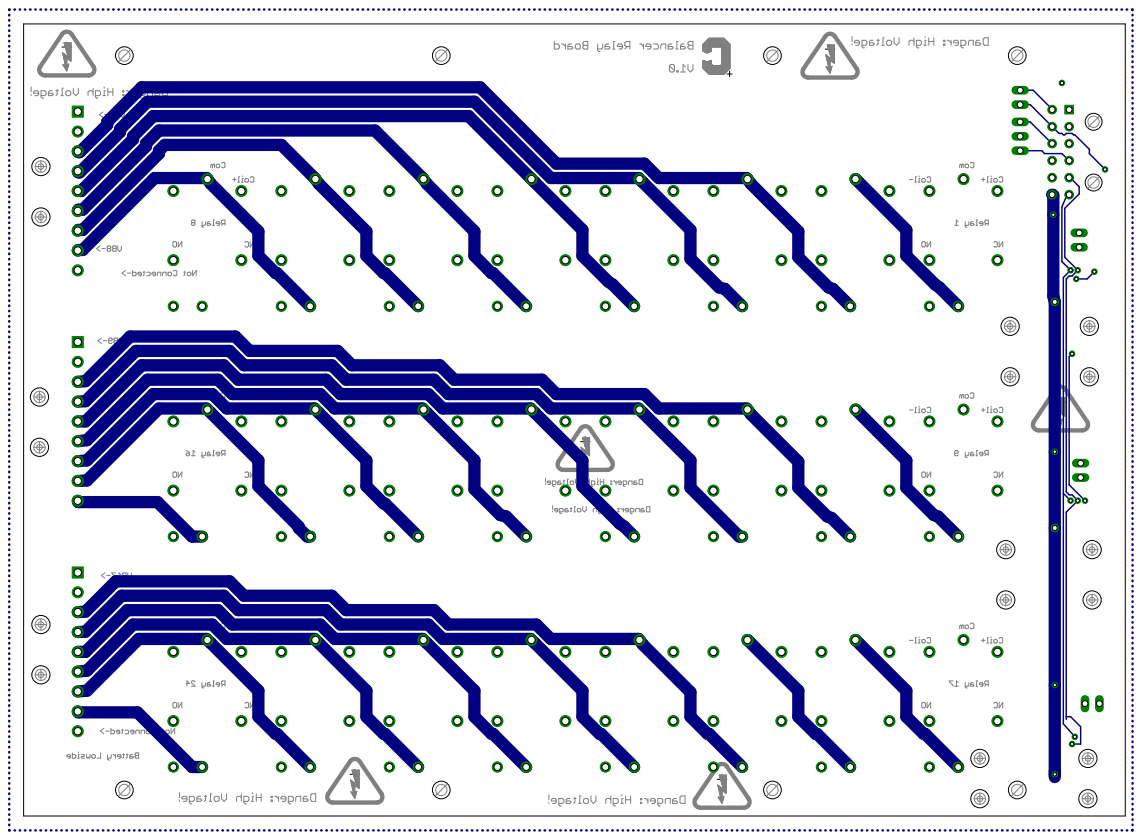
[picture p42: page 1]
