tzarick/Battery-balancer/Hardware/RelayBoard/RelayBoard - top.pdf

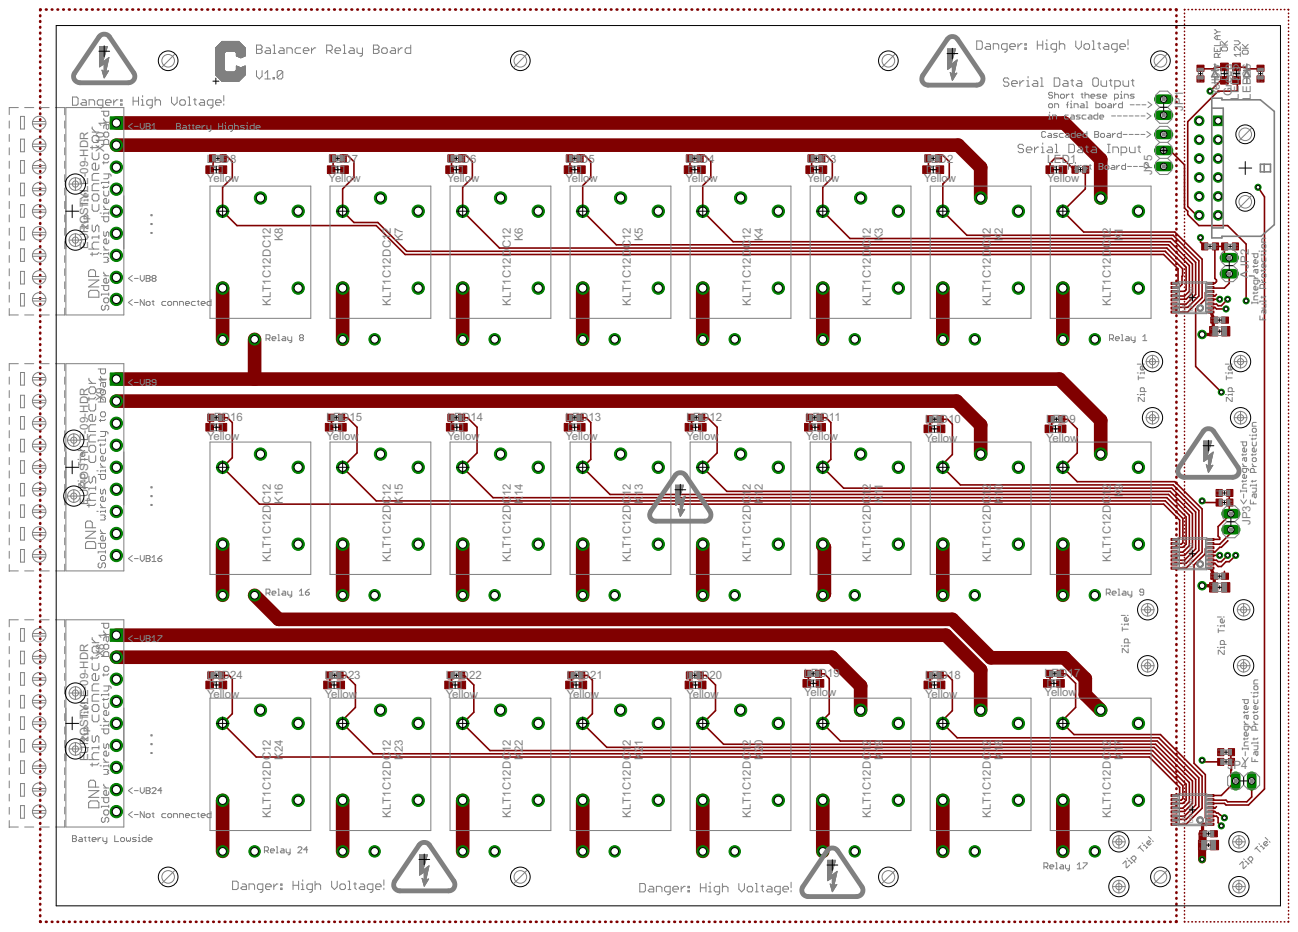
[picture p43: page 1]
