tzarick/Battery-balancer/Software/Logic Flow Diagrams/State.pdf

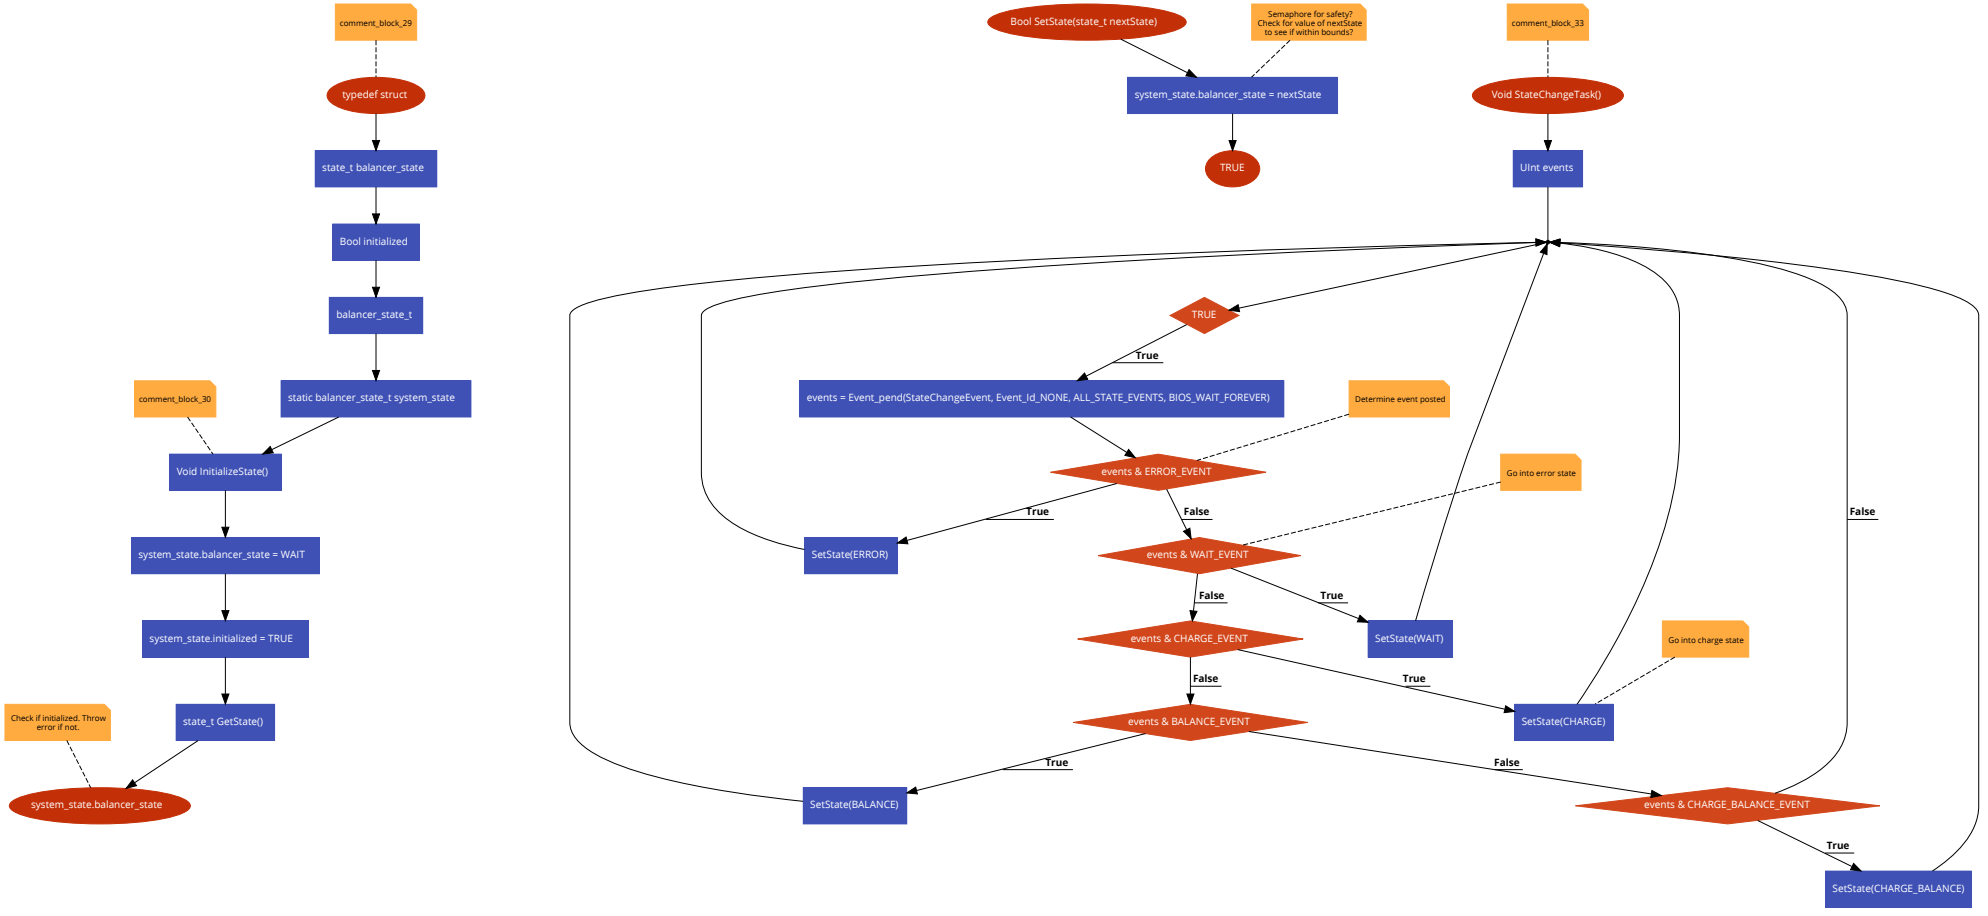
[picture p48: page 1]
typedef struct; state_t balancer_state; Bool initialized; balancer_state_t; static balancer_state_t system_state; Void InitializeState(); system_state.balancer_state = WAIT; system_state.initialized = TRUE; state_t GetState(); system_state.balancer_state; system_state.balancer_state = nextState; TRUE; Void StateChangeTask(); UInt events; events = Event_pend(StateChangeEvent, Event_Id_NONE, ALL_STATE_EVENTS, BIOS_WAIT_FOREVER); True; events & ERROR_EVENT; SetState(ERROR); events & WAIT_EVENT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

Semaphore for safety?
Check for value of nextState
to see if within bounds?

Bool SetState(state_t nextState)

Determine event posted

Go into error state

Go into charge state

Check if initialized. Throw
error if not.
