tzarick/Battery-balancer/Software/Logic Flow Diagrams/CAN/InitECana (CAN).pdf

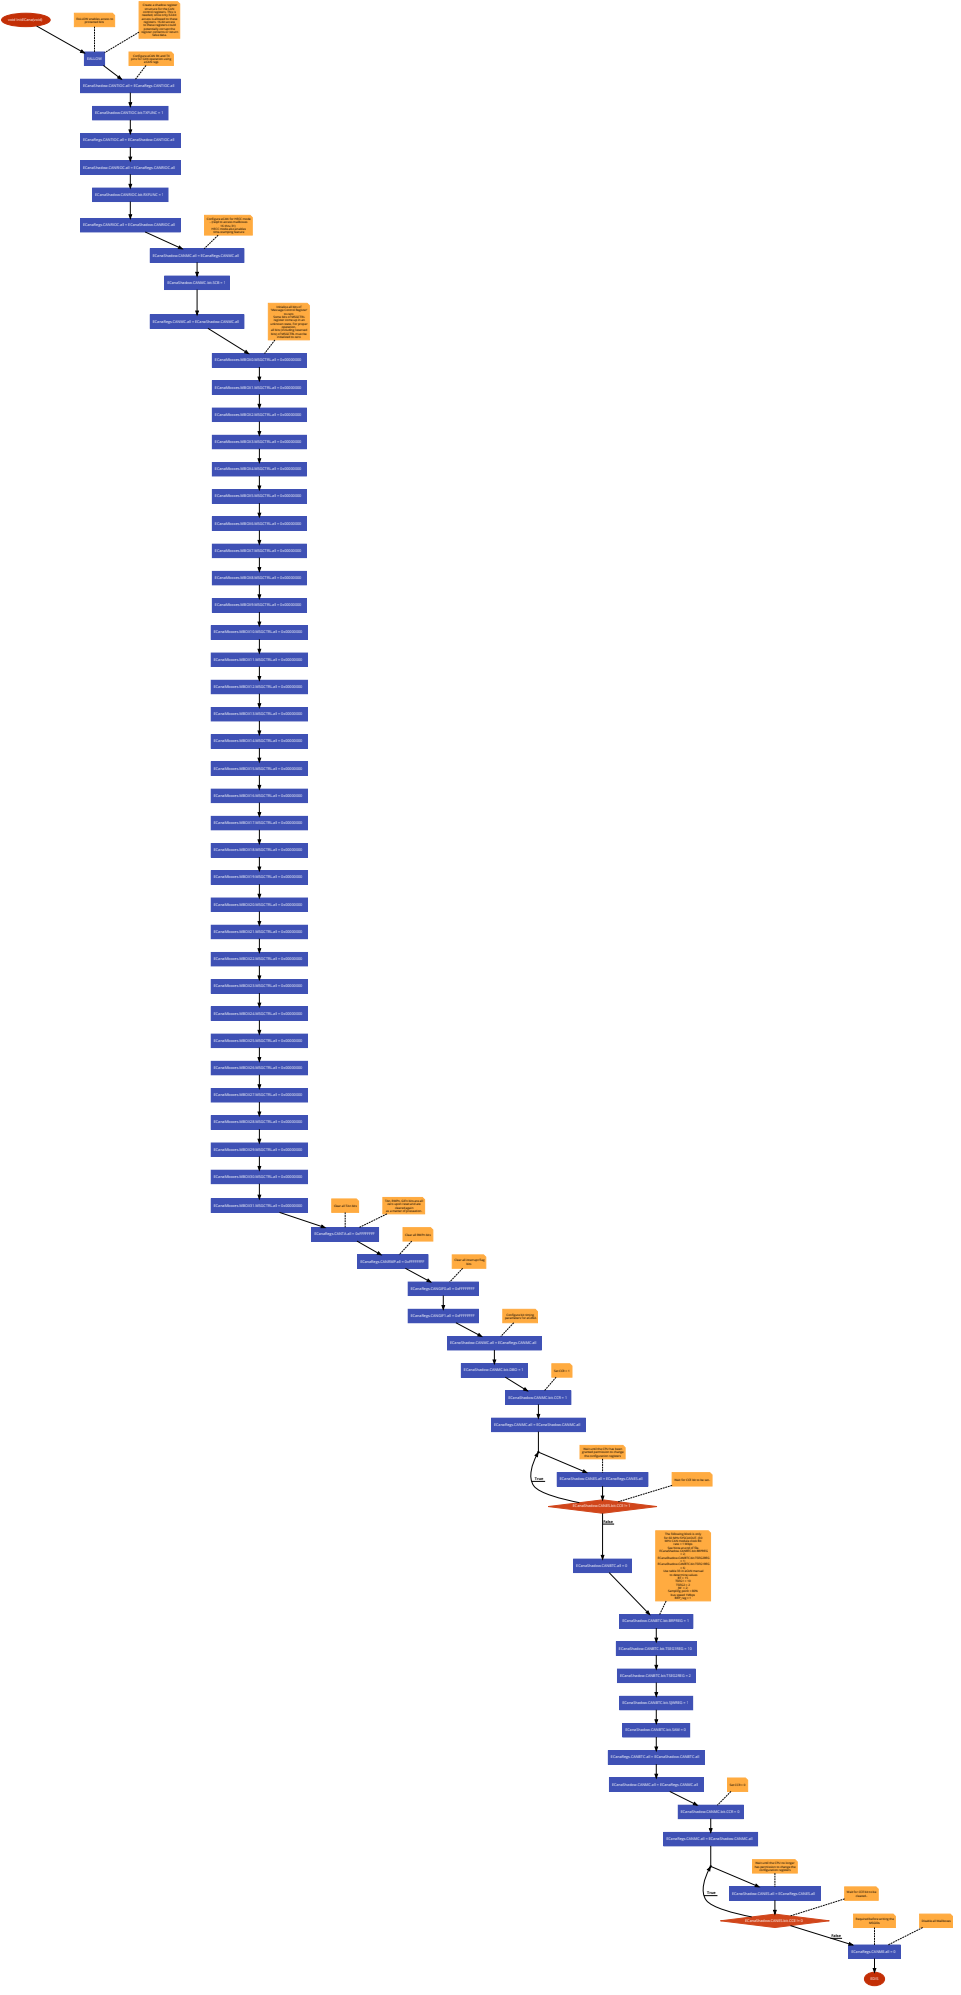
[picture p49: page 1]
EALLOW; ECanaRegs.CANGIF0.all = 0xFFFFFFFF; ECanaRegs.CANGIF1.all = 0xFFFFFFFF; True; False; EDIS; MSGIDs; Set CCR = 0; Set CCR = 1; bits; false data.; eCAN regs; to zero; operation,

Create a shadow register
structure for the CAN
control registers. This is
needed, since only 32-bit
access is allowed to these
registers. 16-bit access
to these registers could
potentially corrupt the
register contents or return

void InitECana(void)

EALLOW enables access to
protected bits

Configure eCAN RX and TX
pins for CAN operation using

ECanaShadow.CANTIOC.all = ECanaRegs.CANTIOC.all

ECanaShadow.CANTIOC.bit.TXFUNC = 1

ECanaRegs.CANTIOC.all = ECanaShadow.CANTIOC.all

ECanaShadow.CANRIOC.all = ECanaRegs.CANRIOC.all

ECanaShadow.CANRIOC.bit.RXFUNC = 1

ECanaRegs.CANRIOC.all = ECanaShadow.CANRIOC.all

Configure eCAN for HECC mode
- (reqd to access mailboxes
16 thru 31)
HECC mode also enables
time-stamping feature

ECanaShadow.CANMC.all = ECanaRegs.CANMC.all

ECanaShadow.CANMC.bit.SCB = 1

Initialize all bits of
'Message Control Register'
Some bits of MSGCTRL
register come up in an
unknown state. For proper
all bits (including reserved
bits) of MSGCTRL must be
initialized to zero

ECanaRegs.CANMC.all = ECanaShadow.CANMC.all

ECanaMboxes.MBOX0.MSGCTRL.all = 0x00000000

ECanaMboxes.MBOX1.MSGCTRL.all = 0x00000000

ECanaMboxes.MBOX2.MSGCTRL.all = 0x00000000

ECanaMboxes.MBOX3.MSGCTRL.all = 0x00000000

ECanaMboxes.MBOX4.MSGCTRL.all = 0x00000000

ECanaMboxes.MBOX5.MSGCTRL.all = 0x00000000

ECanaMboxes.MBOX6.MSGCTRL.all = 0x00000000

ECanaMboxes.MBOX7.MSGCTRL.all = 0x00000000

ECanaMboxes.MBOX8.MSGCTRL.all = 0x00000000

ECanaMboxes.MBOX9.MSGCTRL.all = 0x00000000

ECanaMboxes.MBOX10.MSGCTRL.all = 0x00000000

ECanaMboxes.MBOX11.MSGCTRL.all = 0x00000000

ECanaMboxes.MBOX12.MSGCTRL.all = 0x00000000

ECanaMboxes.MBOX13.MSGCTRL.all = 0x00000000

ECanaMboxes.MBOX14.MSGCTRL.all = 0x00000000

ECanaMboxes.MBOX15.MSGCTRL.all = 0x00000000

ECanaMboxes.MBOX16.MSGCTRL.all = 0x00000000

ECanaMboxes.MBOX17.MSGCTRL.all = 0x00000000

ECanaMboxes.MBOX18.MSGCTRL.all = 0x00000000

ECanaMboxes.MBOX19.MSGCTRL.all = 0x00000000

ECanaMboxes.MBOX20.MSGCTRL.all = 0x00000000

ECanaMboxes.MBOX21.MSGCTRL.all = 0x00000000

ECanaMboxes.MBOX22.MSGCTRL.all = 0x00000000

ECanaMboxes.MBOX23.MSGCTRL.all = 0x00000000

ECanaMboxes.MBOX24.MSGCTRL.all = 0x00000000

ECanaMboxes.MBOX25.MSGCTRL.all = 0x00000000

ECanaMboxes.MBOX26.MSGCTRL.all = 0x00000000

ECanaMboxes.MBOX27.MSGCTRL.all = 0x00000000

ECanaMboxes.MBOX28.MSGCTRL.all = 0x00000000

ECanaMboxes.MBOX29.MSGCTRL.all = 0x00000000

ECanaMboxes.MBOX30.MSGCTRL.all = 0x00000000

ECanaMboxes.MBOX31.MSGCTRL.all = 0x00000000

Clear all TAn bits

TAn, RMPn, GIFn bits are all
zero upon reset and are
cleared again
as a matter of precaution.

ECanaRegs.CANTA.all = 0xFFFFFFFF

Clear all RMPn bits

ECanaRegs.CANRMP.all = 0xFFFFFFFF

Clear all interrupt flag

Configure bit timing
parameters for eCANA

ECanaShadow.CANMC.bit.DBO = 1

ECanaShadow.CANMC.bit.CCR = 1

Wait until the CPU has been
granted permission to change
the configuration registers

ECanaShadow.CANES.all = ECanaRegs.CANES.all

Wait for CCE bit to be set..

ECanaShadow.CANES.bit.CCE != 1

The following block is only
for 60 MHz SYSCLKOUT. (30
MHz CAN module clock Bit
rate = 1 Mbps
See Note at end of file.
ECanaShadow.CANBTC.bit.BRPREG
ECanaShadow.CANBTC.bit.TSEG2REG
ECanaShadow.CANBTC.bit.TSEG1REG
Use table 33 in eCAN manual
to determine values
TSEG1 = 10
TSEG2 = 2
Sampling point = 80%
bus speed 1Mbps
BRP_reg = 1

ECanaShadow.CANBTC.all = 0

ECanaShadow.CANBTC.bit.BRPREG = 1

ECanaShadow.CANBTC.bit.TSEG1REG = 10

ECanaShadow.CANBTC.bit.TSEG2REG = 2

ECanaShadow.CANBTC.bit.SJWREG = 1

ECanaShadow.CANBTC.bit.SAM = 0

ECanaRegs.CANBTC.all = ECanaShadow.CANBTC.all

ECanaShadow.CANMC.bit.CCR = 0

Wait until the CPU no longer
has permission to change the
configuration registers

Wait for CCE bit to be
cleared..

ECanaShadow.CANES.bit.CCE != 0

Required before writing the

Disable all Mailboxes

ECanaRegs.CANME.all = 0
