tzarick/Battery-balancer/Software/Logic Flow Diagrams/CAN/SendCAN.pdf

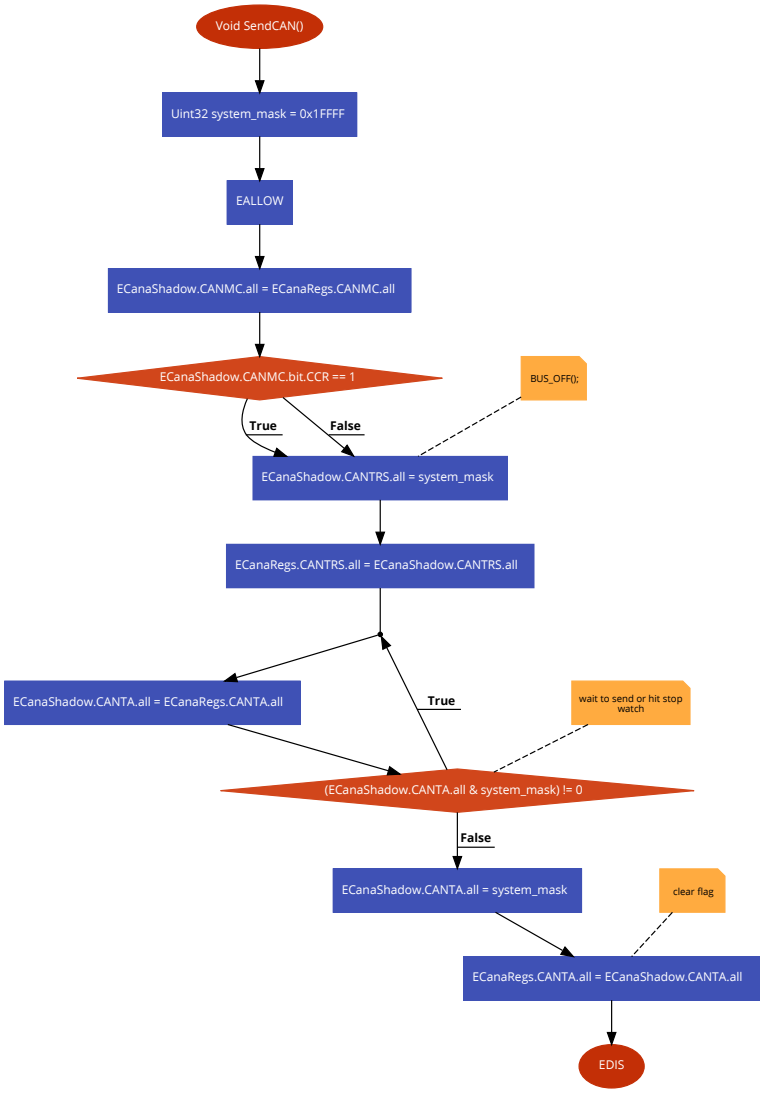
[picture p50: page 1]
Void SendCAN(); Uint32 system_mask = 0x1FFFF; EALLOW; True; False; EDIS; clear flag; BUS_OFF();

ECanaShadow.CANMC.all = ECanaRegs.CANMC.all

ECanaShadow.CANMC.bit.CCR == 1

ECanaShadow.CANTRS.all = system_mask

ECanaRegs.CANTRS.all = ECanaShadow.CANTRS.all

ECanaShadow.CANTA.all = ECanaRegs.CANTA.all

wait to send or hit stop
watch

(ECanaShadow.CANTA.all & system_mask) != 0

ECanaShadow.CANTA.all = system_mask

ECanaRegs.CANTA.all = ECanaShadow.CANTA.all
