tzarick/Battery-balancer/Software/Battery Balancer/Project Includes/BatteryController.h

/*
 * BatteryController.h
 *
 *  Created on: Mar 4, 2016
 *      Author: Sean Harrington
 */

#ifndef PROJECT_INCLUDES_BATTERYCONTROLLER_H_
#define PROJECT_INCLUDES_BATTERYCONTROLLER_H_



void BatteryController_Task(void);

#endif /* PROJECT_INCLUDES_BATTERYCONTROLLER_H_ */
