tzarick/Battery-balancer/Software/Battery Balancer/Project Includes/FrontPanel.h

/*
 * FrontPanel.h
 *
 *  Created on: Mar 4, 2016
 *      Author: Sean Harrington
 */

#ifndef PROJECT_INCLUDES_FRONTPANEL_H_
#define PROJECT_INCLUDES_FRONTPANEL_H_

//------------------------------------------------
// Common Includes

#include "Common_Includes.h"

//------------------------------------------------
// Public variables





//------------------------------------------------
// Public functions





#endif /* PROJECT_INCLUDES_FRONTPANEL_H_ */
