tzarick/Battery-balancer/Software/Battery Balancer/Project Source/Error.c

/*
 * Error.c
 *
 *  Created on: Jan 26, 2016
 *      Author: Sean Harrington
 */

#include "Error.h"

//-----------------------------------------------------------------------
// Global variables
//-----------------------------------------------------------------------

//-----------------------------------------------------------------------
// Constants
//-----------------------------------------------------------------------

//-----------------------------------------------------------------------
// Private variables
//-----------------------------------------------------------------------

//-----------------------------------------------------------------------
// Private (Internal) functions
//-----------------------------------------------------------------------

//-----------------------------------------------------------------------
// Public functions
//-----------------------------------------------------------------------

void Error_HandleError(error_t error)
{
	// todo: Complete
}
