tzarick/Battery-balancer/(commit log)

2016-02-05 Continued I2C implementation. Added beginning of I2C Send task that waits for an outside send event.
    [app.cfg]
2016-02-06 Continued implementation of I2C. Moved completely to event based processing to remain asynchronous on I2C reads and writes.
    [app.cfg]
2016-02-06 Added error macro that will detect a condition and determine if there's an error and how to handle it. Continued I2C implementation - Ready for testing
    [Error.c, Error.h, I2C_Coms.c, I2C_Coms.h]
2016-02-17 Start SPI, made minor changes to other sections of code.
2016-02-21 Started Timer module. Not fully implemented.
    [app.cfg]
2016-02-25 Continued and revised SPI implementation.
2016-03-01 Continued SPI implementation. Fixed timer issues
    [app.cfg]
2016-03-01 New target configuration, fixed issue with typedef
    [Common_Includes.h]
2016-03-04 I2C write working correctly. Adding temporary blinking LED code. I2C read broken.
    [app.cfg]
2016-03-05 I2C read, write, and interrupt working. I2C error handling not tested
    [app.cfg]
2016-03-14 Added battery controller and front panel modules to the software project
    [app.cfg]
2016-03-20 Update progress on clicky boards
    [RelayBoard.brd, RelayBoard.sch]
2016-03-20 Routing and Schematic Updates
    * Routed some traces.
    * Fixed relay indicator LEDs in schematic to be active low and compatible with the DRV8860 driver chip.
    [RelayBoard.brd, RelayBoard.sch]
2016-03-20 Routed comm. lines
    [RelayBoard.brd, RelayBoard.sch]
2016-03-21 11:30 Update
    [RelayBoard.brd, RelayBoard.sch]
2016-03-21 * Removed three unnecessary bypass capacitors * Reoriented signals on X3 connector to make routing easier
    [RelayBoard.sch]
2016-03-21 * Reoriented drivers and associated components. * Rerouted signals
    [RelayBoard.brd]
2016-03-21 Finished routing
    [RelayBoard.brd, RelayBoard.sch]
2016-03-21 * Resolved DRC issues
    [RelayBoard.brd]
2016-03-21 * Adjusted board dimensions
    [RelayBoard.brd]
2016-03-21 * Renamed DOUT_INTERBOARD to DOUT3 and connected to data output of driver 3.
    [RelayBoard.sch]
2016-03-21 * Routed DOUT3 * Added labels to silk screen
    [RelayBoard.brd]
2016-03-21 * Added high voltage symbols to the silkscreen
    [RelayBoard.brd]
2016-03-21 * Added zip tie strain relief holes
    [RelayBoard.brd]
2016-03-21 Renamed DOUT signals for better self documentation
    [RelayBoard.sch]
2016-03-21 * Added power indicator LEDs * Added slave/master jumper
    [RelayBoard.brd, RelayBoard.sch]
2016-03-21 * Finalizing routing changes
    [RelayBoard.brd, RelayBoard.sch]
2016-03-21 * Changed silkscreen text to vector per ECAD standards
    [RelayBoard.brd]
2016-03-22 Created CAM files and board PDFs
    [RelayBoard.brd, RelayBoard.sch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]
2016-03-22 Added zip tie strain relief to battery inputs
    [RelayBoard.brd]
2016-03-22 * Changed jumper device to standard 0.1" spacing pin header.
    [RelayBoard.brd, RelayBoard.sch]
2016-03-22 * Assigned colors to LEDs
    [RelayBoard.brd, RelayBoard.sch]
2016-03-22 Created BOM
    [BoM.xlsx]
2016-03-22 Added arrow to silk screen
    [RelayBoard.brd]
2016-03-22 Made schematic more readable
    [RelayBoard.sch]
2016-03-22 Updated CAM files
    [Board Outline.GKO, Bottom Layer.GBL, Bottom Solder Mask.GBS, Drills.XLN, Top Layer.GTL, Top Silk Screen.GTO, Top Solder Mask.GTS]
2016-03-22 Renamed CAM folder to "Gerbers"
    [Board Outline.GKO, Bottom Layer.GBL, Bottom Silk Screen.GBO, Bottom Solder Mask.GBS, Drills.XLN, Top Layer.GTL, Top Silk Screen.GTO, Top Solder Mask.GTS]
2016-03-23 Changed battery input labeling to match the team's conventions e.g. VB1 -> VC24+
    [RelayBoard.brd, RelayBoard.sch]
2016-03-23 Regenerate clicky board Gerbers
    [Bottom Layer.GBL, Bottom Silk Screen.GBO, Top Layer.GTL, Top Silk Screen.GTO]
2016-05-01 SPI correctly communicating with DRV8860. Need to confirm error fetching functionality works correctly.
    [app.cfg, app_p28L.cfg]
2017-02-19 Update CAN.c
    voltage macro names changed
2017-02-19 Update CAN.h
    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
2017-02-25 Update I2C_Coms.c
    I2C comments
2017-02-25 Battery Balancer Threads
    [BatteryBalancer_Threads.xlsx]
2017-02-26 Updated Documentation on RTOS Threads
    [BatteryBalancer_Threads.xlsx]
2017-03-12 Added Charge and Balance files. Removed unneccessary CellBalancingHoldoff and BatteryControllerFunc. Added RegistersReady set to I2C_Interrupt.
    [app_p28L.cfg]
2017-04-23 Added task for UpdateState in SysBios
    [app.cfg]
2017-05-03 Added comments for things because I have no idea what I'm doing
    [app.cfg]
2017-05-15 Bug fixes and error handling updates
    [app.cfg]
